zleffke/kicad_active_balun/qucs/lwa_ref/README.md

# LWA Filter Simulations

- lwa_lpf.sch: design built into LWA FEE v1.7, Fc = 158 MHz
- lwa_bpf.sch: proposed LWA BPF:, AM Band rejection.
- lwa_bpf2.sch: proposed LWA BPF, with FM band Notch.
