zleffke/kicad_active_balun/docs/Initial Design/sections/general_information.tex

\newpage
\section{General Information}
\label{sec:general_introduction}

\subsection{Purpose}
\label{subsec:purpose}
The purpose of this document is to describe the initial design of an active HF dipole antenna. This document is intended to provide the initial design decisions that went into the development of this antenna system.  While the full antenna wil eventually be discussed, this document will primarily discuss the development and test of the core Printed Circuit Board (PCB) developed for the project. 

\subsection{Scope}
\label{subsec:scope}
As an initial design document, the scope of this document may be fairly broad.  The primary focus will be on the development of the core PCB active dipole balun board.  The document may also include test procedures, test results,  antenna performance on air, and other areas as necessary.

\subsection{Project References}
\label{subsec:references}
LWA Memo Series: \url{https://www.faculty.ece.vt.edu/swe/lwa/}

\noindent Reeve Observatory LWA Antenna Page:\\ \url{http://www.reeve.com/RadioScience/Antennas/ActiveCrossed-Dipole/LWA_Antenna.htm}

\noindent HamSCI: \url{https://hamsci.org/basic-project/personal-space-weather-station}

\subsection{Technical Points of Contact}
\label{subsec:poc}
\renewcommand{\arraystretch}{1.2}
%\begin{center}
	\begin{tabular}{|r|l|}
		\hline
		Name: & Zach Leffke \\
		\hline
		Email: & zleffke@vt.edu \\
		\hline
		Phone: & (540)808-6305 \\
		\hline
	\end{tabular}
%\end{center}
