zleffke/kicad_active_balun/docs/Initial Design/sections/prototype.tex

\newpage
\section{Prototype Crossed Dipole HF Antenna}

\label{sec:prototype}

\subsection{Antenna Element Selection}
\label{subsec:proto_ant_element}

\subsection{PCB Assembly}
\label{subsec:proto_pcb}
