zleffke/kicad_active_balun/docs/Initial Design/sections/schematic.tex

\newpage
\section{Schematic}
\label{sec:schematic}

The interested reader is highly encouraged to read the relevant documentation from the LWA Memo Series.

\begin{sidewaysfigure}
  \centering
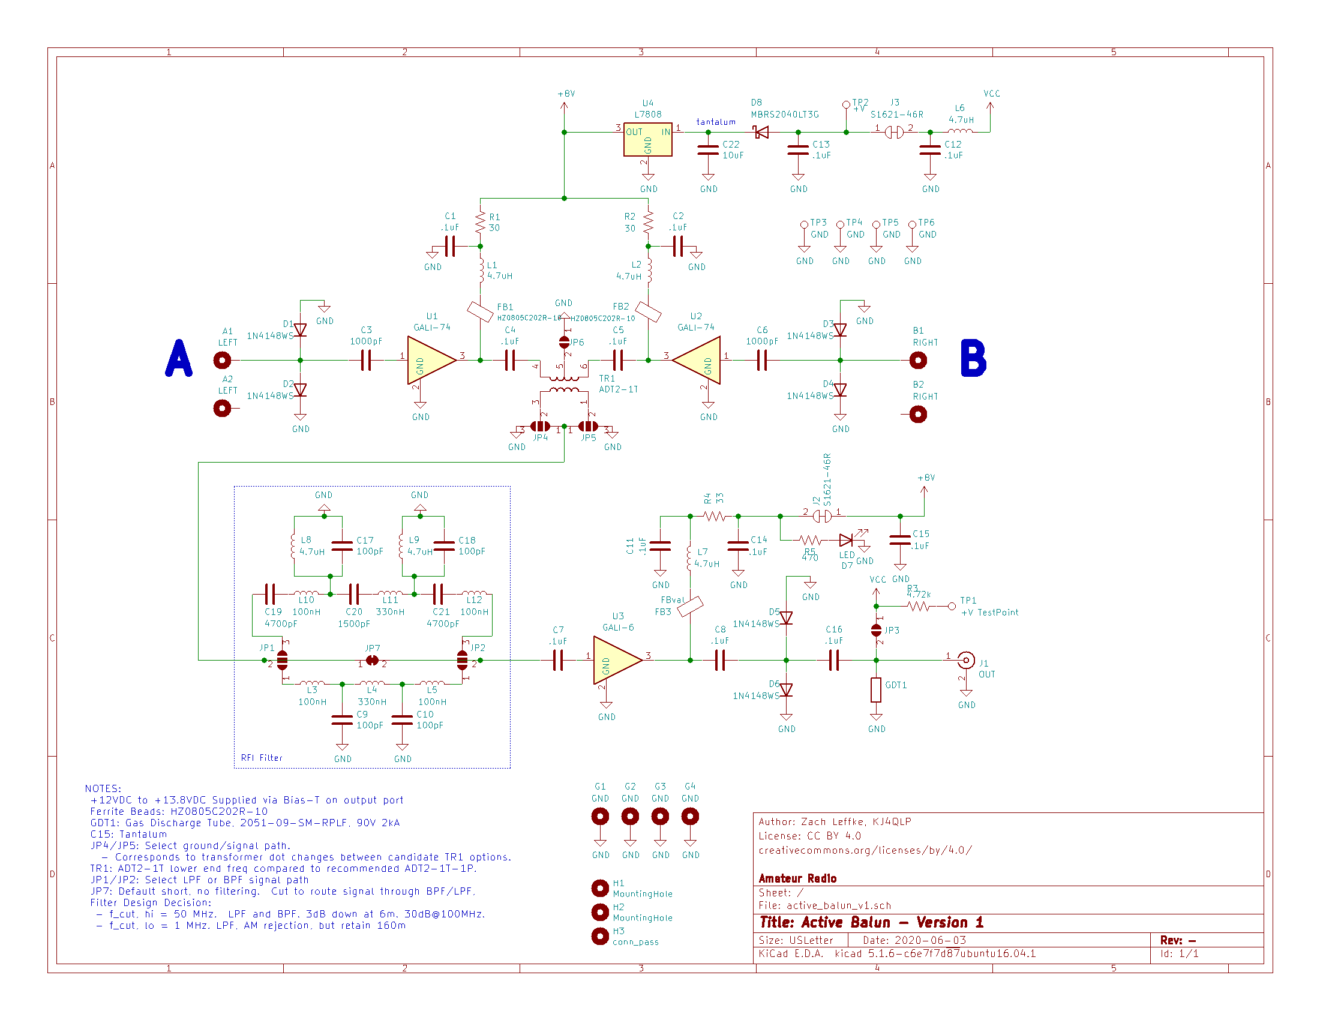
[picture p2: docs/Initial Design/figures/schematic.png]
  
  \caption{Version 1, Revision - Schematic.}
  \label{fig:schematic}
\end{sidewaysfigure}

\begin{figure}[h]
  \centering
  \begin{subfigure}{.45\textwidth}
    \centering
    
    \caption{PCB Top.}
	\label{fig:osh_park:top}
  \end{subfigure}%
  \begin{subfigure}{.45\textwidth}
    \centering
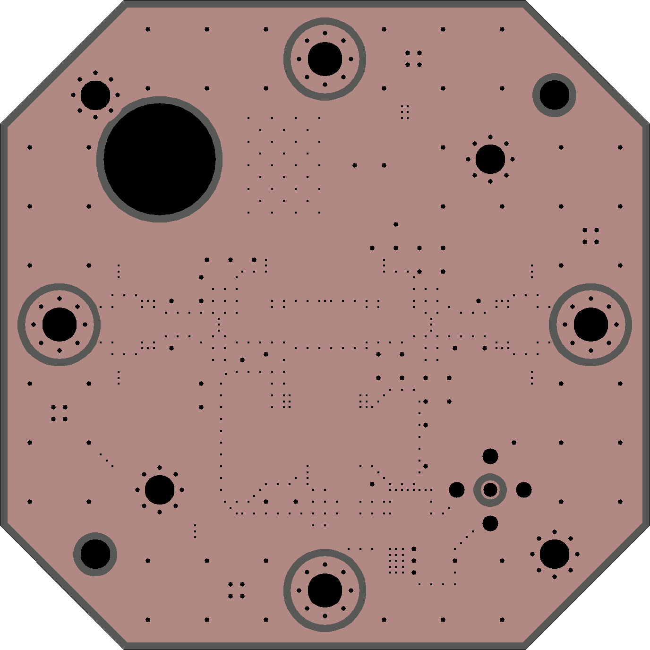
[picture p3: docs/Initial Design/figures/osh_park_bottom_view.png]
    
    \caption{PCB Bottom.}
	\label{fig:osh_park:bottom}
  \end{subfigure}
  \caption{Prefabrication PCB depiction from Osh Park.}
  \label{fig:osh_park}
\end{figure}
