zleffke/kicad_active_balun/docs/Initial Design/initial_design.pdf

# Active HF Dipole Balun Initial Design Document

Project | Active HF Crossed Dipole, HamSCI PSWS
Document ID | AHFDB-IDD
Version | 0.0.1
Date | 20200716
Prepared By | Zach Leffke, KJ4QLP
Keywords | HF Crossed Dipole, SDR, HamSCI PSWS

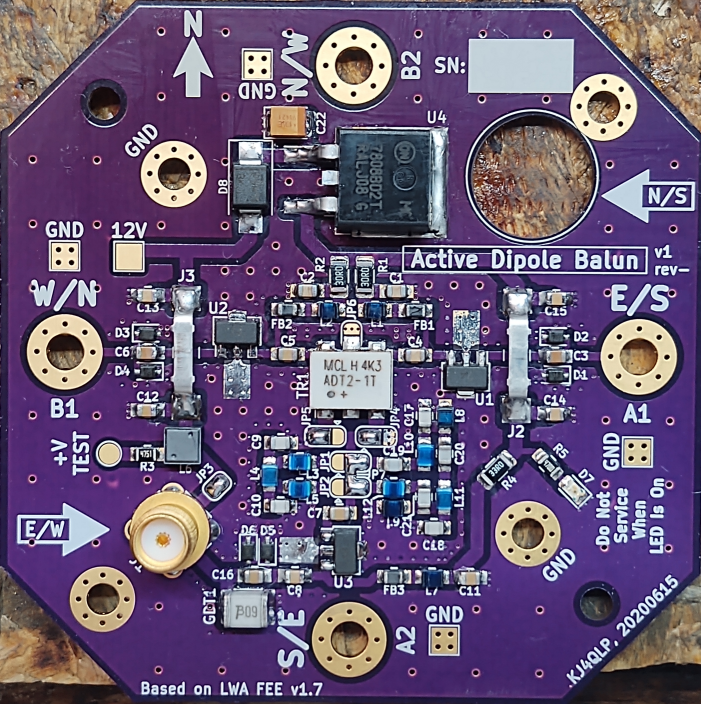
[picture p7: figure]
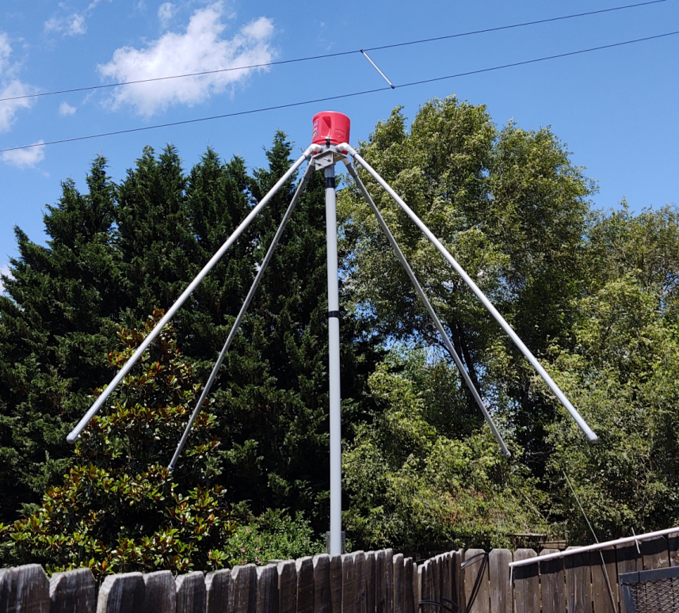
[picture p8: figure]

KJ4QLP

AHFDB-IDD | v0.0.1

## Contents

1 Executive Summary | 2
2 Introduction | 2
2.1 Motivation | | 3
2.2 Design Inspiration - LWA FEE v1.7 | | 3
2.3 Project Goals | | 3
2.3.1 | Open Design | | 3
2.3.2 | Technical | | 4
3 Technical Description | 4
3.1 Background | | 4
3.2 Design Feature Overview | | 5
3.3 Design Deviations from LWA | | 7
3.3.1 | 180◦ Hybrid Combiner vs RF Transformer | | 7
3.3.2 | Filtering | | 8
3.3.3 | Voltage Regulator | | 10
3.4 Polarization | | 10
4 Schematic | 12
5 Measurement | 14
5.1 Performance Metrics Definition | | 14
5.2 Measurement Results | | 14
6 Prototype Crossed Dipole HF Antenna | 15
6.1 Antenna Element Selection | | 15
6.2 PCB Assembly | | 15
7 Conclusion | 16

## List of Figures

1 | Block Diagram of Single Polarization Active HF Dipole Balun | | 2
2 | LWA-FEEv1.7 low pass filter schematic and response simulation in QUCS | | 8
3 | Active HF dipole balun version 1, revision- (AHFDB, v1, rev-) low pass filter schematic
and response simulation in QUCS | | 9
4 | Noise Figure Measurement Setup | | 11
5 | Version 1, Revision - Schematic | | 13
6 | Prefabrication PCB depiction from Osh Park | | 14
20200716 | KJ4QLP | i

AHFDB-IDD | 0.0.1

## List of Tables

1 | Relevant documents from the LWA Memo Series | | 5
2 | Summary of Active HF Dipole Balun Performance Parameters | | 6
3 | Summary of design deviations from the LWA-FEEv1.7 reference design | | 7
4 | Pinouts of the Mini-Circuits ADT2-2-1T-1P & the ADT2-1T RF transformers . . . | 8
20200716 | KJ4QLP | 1/ 16

## 1 Executive Summary

This paper presents the initial design information describing an Active HF Dipole Balun (AHFDB). A single balun board provides a single linear polarized dipole antenna for HF receive only applications. A pair of balun boards can be combined to produce an active HF crossed dipole, which when phased together properly can produce circular polarization for Extraordinary and Ordinary mode discrimination. The fundamental design is heavily based on the LWA Front End Electronics, version 1.7 (LWA-FEEv1.7) from the Long Wavelength Array radio astronomy instrument, with notable differences and adaptations to make it easy to reproduce and to reduce overall costs. To date, three balun boards have been assembled and heavily tested. This includes extensive benchtop measurements of RF parameters such as Gain, Noise Figure, Input P1dB, IIP3, Input VSWR, Output VSWR, and response of the integrated RFI filters. This testing also included on air measurements with an assembled active HF crossed dipole which utilizes two of the assembled baluns. The on air testing includes comparisons measurements to two commercial antennas, an active magnetic loop from DX Engineering and a Tilted Terminated Dipole Antenna (T2FD). This project was undertaken by the author in order to provide a low cost alternative to more expensive commercially available products of similar design. The goal of this document is to provide the design details of this device in an readily accessible way so that other experimenters can easily reproduce the design. While intended for Amateur Radio experimenters and DIYers, the overall design is intended to be sufficient for the conduct of serious radio science research. Overall, the design performs very well, generally as good or better than commercial variants, at a dramatically reduced cost. Figure 1 below shows the high level block diagram of a single balun design.

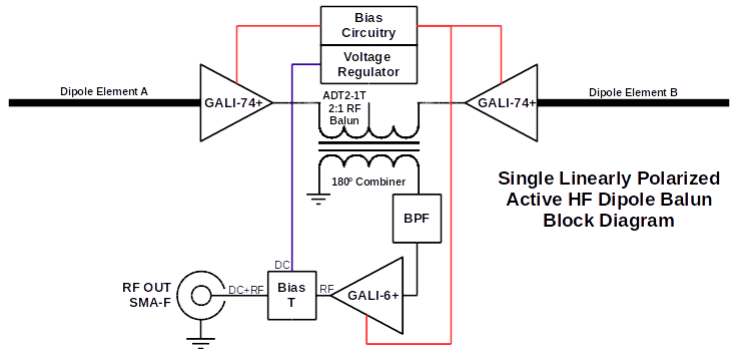
[picture p9: figure]

Figure 1: Block Diagram of Single Polarization Active HF Dipole Balun.

## 2 Introduction

This paper will provide a description of the Active HF Dipole Balun design. Like the base design, the author hopes to take inspiration from the Long Wavelength Array (LWA) radio astronomy project in the form of a Memo Series documenting the development of this project. This document

20200716 | KJ4QLP | 2/ 16

is a starting point to capture the main ideas and high level information. As the design progresses, this document may be condensed and content moved into other more focused documents.

### 2.1 Motivation

For a while now, the author has been interested in developing an active HF Dipole antenna system for HF reception. This is in part due to an interest in the Amateur Radio hobby and general interest in ionospheric science and associated instrumentation. The HamSCI Personal Space Weather Station (PSWS) project has also served as motivation to pursue this effort. This project is also related to an interest of the author in developing HF reception and transmission systems as part of his professional work with the Virginia Tech Hume Center for National Security and Technology. This includes HF systems for both ground based observations as well as space based reception/transmission of HF signals (ePOP RRI). The author would like to thank the VT Hume Center for use of the RF test equipment used to perform detailed RF measurements of the design presented in this work.

### 2.2 Design Inspiration - LWA FEE v1.7

Through research into active HF antenna systems and digital receiver systems, the author has come across the LWA Memo Series hosted by Dr. Steve Ellingson of Virginia Tech (VT) [1]. This information was initially discovered when looking through the excellent content on the Reeve Observatory website [2]. The Long Wavelength Array is a radio astronomy instrument that consists of hundreds of active HF crossed dipole antenna elements and involves UNM, VT, LANL, JPL, NRL, Caltech, Harvard, NRAO, and AFRL. At least two such large arrays exist, one in Socorro, NM at the Very Large Array (VLA) site [3] and one at the Owens Valley Radio Observatory (OVRO) site in California [4].
The LWA Memo series contains over two hundred individual documents concerning the design of the entire radio astronomy instrument. This memo series includes everything from the base antenna design (of interest to this work), to the siting requirements for the observatories, to the correlator designs, to the networking requirements, and many other topics. Reading through the excellent information on both the Reeve Observatory site and the LWA Memo Series has lead the author to consider the use of the LWA design for the an active HF antenna design for Amateur Radio use and Ionospheric science research.
The fundamental design of the active balun PCB board presented in this work is based directly on the LWA Front End Electronics (FEE) v1.7 board, with notable differences that will be discussed later. The author in no way claims credit for the base design as it is directly taken from the LWA documents. The author would like to thank the LWA researchers and engineers for publishing such excellent, detailed, and readily accessible information concerning the design of their antenna system.

### 2.3 Project Goals

### 2.3.1 Open Design

A primary goal of this project is to provide a low cost solution for experimenters interested in constructing active HF antennas. The intent of the author is to make the design easily accessible,

20200716 | KJ4QLP | 3/ 16

reproducible, and generally easy for others to use and create they’re own. A PCB layout, based on the LWA FEE v1.7 but updated and modified, was done by the author using KiCAD. The PCB layout is open hardware, based on the creative commons license, and available on GitHub for others use, modification, etc. Prototype PCBs were fabricated by Osh Park, and the author is considering making Osh Park project public once a satisfactory design revision has been completed. When made public on the Osh Park page, others can order boards directly by other experimenters rather than having to download the KiCAD designs and creating their own PCB project. The Bill of Materials will also be provided and all components are easily obtainable from local hardware stores and online vendors such as Mouser, Digikey, Osh Park, etc.

### 2.3.2 Technical

There are a number of technical goals for this project that will be discussed in more detail in subsequent sections. This section of the document is intended to provide high level insight into the overall project. The list below shows the basic design goals.

1. Single, linearly polarized, active balun board for an electrically small HF dipole antenna.
2. Modular design to produce a crossed dipole configuration with a pair of active balun boards.
3. Threshold frequency of operation: 3.0 to 30.0 MHz.
4. Objective frequency of operation: 1.5 to 50.0 MHz.
5. High linearity in order to handle strong in band signals.
6. Integrated filtering to provide rejection of the AM broadcast band and the FM broadcast band so as not to overdrive the analog RF front end or the backend SDR.
7. Stable performance across the operating band in potential extreme temperature environments (both hot and cold).
8. Relatively compact design using readily available components. The PCB layout uses surface mount components, nominally 0805 in size, allowing board population by hand. Some components are slightly smaller than this and care must be taken during board population.
9. Overvoltage (due to potential nearby lightning strikes) and surge protection.
10. Integrated Bias-T for DC on the coax power supply or via a separate external source.
11. Readily available component selection from common vendors such as local hardware stores (i.e. Lowe’s) and online vendors such as Digikey, Mouser, Mini-Circuits, and Osh Park.
12. First versions and revisions of the design will include prototyping features in the schematic and PCB layout to allow for experimentation that are not part of the LWA design.

## 3 Technical Description

### 3.1 Background

As mentioned, this design is heavily based on the Long Wavelength Array antenna element design. The reader is highly encouraged to review the relevant documents from the LWA Memo Series as full description of their design is outside the scope of this document [1]. Table 1 below gives a list of the key documents from the LWA Memo Series used in this work. However, when necessary, details of the LWA design will be discussed, particularly when discussing deviations from the LWA

20200716 | KJ4QLP | 4/ 16

design as summarized in Table 3. The documents listed in the table pertain specifically to the technical design of the active balun board. There are a number of other documents on the LWA Memo Series [1] that discuss topics such as the antenna element design (blade, wire, etc.), antenna patterns, ground screens, RFI site surveys, potential applications of the LWA, along with many other topics for the overall radio observatory that are not relevant to this work (though all make for very interesting reads).

Table 1: Relevant documents from the LWA Memo Series.

Memo# | Document Title
190 | Collected LWA Engineering Memos from the Development of the Front End Elec-tronics (FEE) [5]
188 | Preliminary Design of the LWA-1 Array, Antenna, Stand, Front End Electronics, and Ground Screen [6]
87 | A Comparison of Two Power Combining Elements for LWA Active-Baluns - 180◦ Hybrid versus Wideband Transformer [7]
120 | The Rapid Test Array Balun (G250R) [8]
135 | Bias-T Design Considerations for the LWA [9]

### 3.2 Design Feature Overview

A single balun board provides the necessary electronics for a single linearly polarized HF dipole antenna. The active balun board provides good performance across the objective frequency of operation from approximately 1.5 to 50.0 MHz, with good rejection in the AM and FM broadcast bands. The performance values given in this section are the average values for the nominal frequency of operation, with more detailed measured performance given in later sections. The active balun board provides an average gain of 36.1 dB. The input third order intercept point (IIP3) is approximately -2.5 to -3.0 dBm across the operating band. The input 1dB Compression Point (P1dB) is approximately -18.41 dBm across the operating band. Note that linearity measurements (IIP3 and P1dB) are taken with the output ESD protection diodes removed from the boards under test, per the measurement techniques described in the LWA documents.
The active HF dipole balun board utilizes a pair of GALI-74+ amplifiers from Mini-Circuits as the primary active amplifier device, one for each element of a single dipole. The signals from each dipole element are then combined using the secondary coil of a Mini-Circuits ADT2-1T RF transformer, which also provides a 180 degree phase shift between the two elements. The ADT2-1T transformer also provides a 2:1 impedance ratio, converting a nominal 100Ω secondary coil to a 50Ω output impedance on the primary coil. The signal is then routed through either a low pass or a band pass RFI filter via surface mount solder jumpers. In its default configuration, these filters are bypassed with a surface mount trace that can be cut with a razor blade if the the filters are desired to be used. The output of the filters are then passed to a GALI-6 amplifier.
A number of surge protection devices and decisions are included in the LWA-FEEv1.7 design
20200716 | KJ4QLP | 5/ 16

and remain essentially unaltered in this design. This includes 1N914 double backed diodes on the RF input and RF output lines serving as ESD protection. The design also includes a Gas Discharge tube on the RF output path to protect back end electronics from damaging lightning surges. These diodes directly effect the measurement process, particularly with respect to linearity measurements (IIP3 and P1dB), as mentioned previously. Finally, the two input capacitors, connected to the dipole element arms, are rated for 1000 volts. This decision is elaborated on in the failure analyses presented in the LWA documentation [5] where the original capacitors had failed short. This was presumably due to nearby lighting that produced an overvoltage condition.
The PCB hole patterns are designed so that a second balun board can be flipped 180 degrees along the top left to bottom right diagonal and maintain proper alignment. When this is done, the two boards can be mechanically mated and held together with four 4-40 screws. The solder mask on the bottom of the PCBs has been removed such that the ground planes of the two boards are also electrically connected. The second PCB SMA connector can then be mounted on the bottom of the PCB and aligned with the large hole in the upper right section of the top PCB, resulting in both SMA connectors pointing ‘up.‘
Each balun board consumes approximately 250 mA when supplied with approximately 13.8VDC. Power is nominally supplied via the output RF coaxial cable, and the design contains an integrated bias-t circuit. In addition, the board allows for direct supply of power via solder pads that bypass the input bias-t. The bias-t can be completely disconnected from the output RF by disconnecting a solder jumper, though the expected power arrangement when fielded should be via the coaxial cable, which provides a degree of shielding, rather than via a separate power line (which also increases overall costs).

Table 2: Summary of Active HF Dipole Balun Performance Parameters.

Parameter | Symbol | Unit | Value
Frequency of Operation | fnom | MHz | 1.5 to 50
Integrated BPF, low -3dB cutoff | flo | MHz | 1.0
Integrated BPF, high -3dB cutoff | fhi | MHz | 50.0
Integrated BPF, high -3dB cutoff | fhi | MHz | 50.0
Average Gain | Gavg | dB | 36.1
Input Compression Point | P1dB | dBm | -18.41
Input Third Order Intercept Point | IIP3 | dBm | -2.5 to -3.0
DC Input Voltage, Range | Vin,range | V | 10.0 to 35.0
DC Input Voltage, Nominal | Vin,nom | V | 13.8
DC Supply Current, Nominal | Isupply | mA | 250.0
DC Supply Method, Nominal | N/A | N/A | bias-t via coax
DC Supply Method, Alternate | N/A | N/A | external
20200716 | KJ4QLP | 6/ 16

### 3.3 Design Deviations from LWA

Table 3: Summary of design deviations from the LWA-FEEv1.7 reference design.

LWA Design | AHFDB Design
Frequency: 10 to 88 MHz | Frequency: 1.5 to 50 MHz
Teletech 180◦ hybrid combiner | Mini-Circuits RF transformer
Low Pass Filter | LPF, BPF, Filter Bypass
12V Voltage Regulator | 8V Voltage Regulator
LWA-FEEv1.7 PCB form factor | More compact PCB form factor

3.3.1 180◦ Hybrid Combiner vs RF Transformer

The LWA-FEEv1.7 utilizes a Tele-Tech HX62A 180◦ hybrid combiner to combine the signals from each side of a single polarization dipole element. The LWA documentation quotes various costs for this single component range from $20.00 per unit when >500 are purchased [6] to $31.50 per unit >500 units are purchased [5]. The lower cost is from a more recent document (2009), and for a dual polarization implementation two of these units would be required. The cost for 2 units is likely higher than the quoted costs which assumes a purchase quantity of more than 500 units. This is cost prohibitive for this project, therefore it was decided that the Tele-Tech HX62A is a non-starter for this project and a suitable, lower cost alternative is required, even if that means accepting a compromise in performance.
The LWA engineers performed an analysis comparing the Tele-Tech HX62A to a Mini-Circuits ADT2-2-1T-1P RF transformer [7]. The results of the analysis show that the HX62A outperforms the ADT2-2-1T-1P. The conclusion of that document is that the increased cost of the Tele-Tech device is worth the increased performance for the LWA design goals. The Mini-Circuits component is drastically lower in cost, and the author believed it was a suitable for this project. However, according to the Mini-Circuits ADT2-2-1T-1P datasheet, the low end frequency response bottoms out around 8 MHz, and the new design is striving for low end performance down to approximately 1.5 MHz to cover the 160m Amateur Radio Band. Alternatively, the Mini-Circuits ADT2-1T datasheet shows a low end response of 0.4 MHz, as well as decreased insertion loss and better return loss across the HF band. The cost of this device is $5.77 per unit on Minicircuits. For this reason, the ADT2-1T was selected for this project.
Table 4 shows the pinouts for the RF transformers. Careful scrutiny of pins 4 and 6 shows that there is an inversion of the secondary between the two transformers, which has implications for the phase of the output signal on the primary coil. In the LWA comparison document [7], pin 3 (primary dot signal) is grounded. Due to the inversion of the primary/secondary orientation on the ADT2-1T compared to the ADT2-2-1-T, the author elected to include solder jumpers in the PCB layout that allows alternate signal routing paths. This allows for experimentation with which pin is grounded and the resulting phase. For the default test case in the version 1, rev- design, pin 1 (primary signal) is grounded to account for the phase inversion. Likely, this concern probably
20200716 | KJ4QLP | 7/ 16

Table 4: Pinouts of the Mini-Circuits ADT2-2-1T-1P & the ADT2-1T RF transformers

Pin | ADT2-2-1T-1P | ADT2-1T
1 | primary | primary
2 | not used | not used
3 | primary dot | primary dot
4 | secondary dot | secondary
5 | secondary ct | secondary ct
6 | secondary | secondary dot

doesn’t matter as long as the active balun boards are consistent, therefore the solder jumpers will likely be removed in future revisions.

### 3.3.2 Filtering

The original LWA design utilizes a 5 pole Butterworth Low Pass Filter (LPF) as a modest Radio Frequency Interference (RFI) filter with a -3dB cutoff frequency of approximately 150 MHz. Figure 2 below shows a Quiet Universal Circuit Simulator (QUCS) simulation of the LWA LPF included in the LWA-FEEv1.7 according to the LWA design documents [5]. With a 3dB bandwidth that spans DC to 150 MHz, effectively no rejection of either the broadcast AM or broadcast FM bands are provided.


Figure 2: LWA-FEEv1.7 low pass filter schematic and response simulation in QUCS.

20200716 | KJ4QLP | 8/ 16

As described earlier, a design goal of this project is to aim for a nominal operating bandwidth between 1.5 MHz and 50.0 MHz. Another goal is to provide some amount of rejection to the broadcast AM and broadcast FM bands. While some of the LWA documents do discuss the inclusion of a notch filter for the broadcast FM band around 98 MHz (center of the FM band), due to the overall changes in the desired operating frequency, the author elected to replace the LPF with a bandpass filter (BPF). For experimentation purposes, the author elected to also include a low pass filter with a modified -3dB cutoff frequency of 50 MHz. Again, selection of the desired filter (LPF or BPF) is accomplished via solder jumper signal routing. In addition to the LPF and BPF, the actual default configuration of the filter section of the PCB is to bypass all filters, again with a surface mount PCB jumper. During initial PCB assembly, this jumper can be cut with a small razor blade and the solder jumpers are then used to route the signal through either the BPF or the LPF. The author utilized QUCS to design the initial filters, which are 5 both pole Butterworth designs. The computed ideal values for the capacitors and inductors were then modified to match readily available standard values. The circuit design and results of the QUCS simulation for the new LPF is shown in Figure 3a and for the new BPF in Figure 3b.


(a) AHFDB v1,rev- low pass filter. | (b) AHFDB v1,rev- band pass filter.

Figure 3: Active HF dipole balun version 1, revision- (AHFDB, v1, rev-) low pass filter schematic and response simulation in QUCS.

Notice the upper -3dB cutoff frequency for both filters in Figure 3 is approximately 50 MHz. At approximately 98 MHz, the center of the broadcast FM band, both filters achieve approximately -30 dB of rejection. The lower -3dB cutoff frequency of the BPF is approximately 1.0 MHz, with minimal insertion loss around 1.8 MHz (the low end of the Amateur Radio 160m band). This low end is a bit below the upper edge of the AM broadcast band (1.6 MHz), but because of the close proximity to the Amateur Radio 160m band, a balance had to be struck. For this first test, it was decided to go with the 1 MHz cutoff as the actual filter performance is not expected to perfectly match the QUCS simulations and the design could be optimized later. On air performance tests at

20200716 | KJ4QLP | 9/ 16

the author’s QTH, presented in more detail later, shows this provides sufficient AM band rejection of local nearby AM stations (including one station less than 1 mile from the author’s QTH). Adding additional poles to the filters is possible, but will increase insertion loss in the pass band. Adding a notch filter is also feasible. As this is an Open Hardware design, including the QUCS simulations, KiCAD schematic, and PCB layout, others are encouraged to experiment with these values to find the right filter response for their local RFI environment.

### 3.3.3 Voltage Regulator

The LWA-FEEv1.7 utilizes a 12V voltage regulator onboard the PCB. For this design, the author has considered the possibility that the antenna may be utilized during portable operations operating from batteries. Prior experience has shown that nominal 12V batteries when fully charged can reach voltages in excess of 14 volts. When depleted 12V batteries can drop as low as 10 to 11 Volts. Therefore, the author made a design decision to down size the onboard voltage regulator to an 8 volt output voltage regulator in order to allow operation at supply voltages as low as approximately 10 volts. This decision has a couple of implications.
First, the bias resistors for the GALI-74 and GALI-6 amplifiers must be modified to account for this change in the overall supply voltage. This is easily accomplished and the Mini-Circuits datasheets provide recommended bias resistor values for various circuit supply voltages. The author did actually experiment with lower than recommended bias resistor values in order to increase the current draw of the balun boards. This was done based on the higher compression point and third order intercept point values shown in the detailed test data documents provided by Mini-Circuits. Ultimately though, this was abandoned and the author reverted to a single bias resistor value of 39 ohms for all three RF amplifiers in the design. Further linearity testing may be conducted on future revisions of the design.
Second, a single polarization board pull approximately 250 mA (at 13.8V input voltage). When using a standard 13.8V power supply (common in Amateur Radio), this results in a voltage difference of approximately 5.8V between the input and output voltages of the regulator. A simple rule of thumb for computing the waste power through a linear regulator is to multiply the current draw by the voltage difference. This results in approximately 1.45 Watts of waste power for a single board and approximately 2.90 Watts when configured for dual polarization. This waste power is not insignificant and manifests in the form of heat. The voltage regulator is a D2PAK form factor and the heat is conducted into the ground plane of the PCB. The ground planes of a dual polarization stack are in contact with each other when mechanically mated. The result of all this is that the temperature of the balun boards achieved a fairly high temperature that was hot to the touch. However, no part of the board was hot enough to cause burns or pain and the increased temperature may actually help stabilize the overall balun temperature when fielded in a completed system, particularly in colder regions.

### 3.4 Polarization

A single active balun PCB board provides a single linearly polarized, electrically small dipole, also referred to as a short dipole. The PCB is designed in such a way that a pair of active balun boards can be stacked together to produce a crossed dipole. The crossed dipole design is desirable

20200716 | KJ4QLP | 10/ 16

in order to discriminate between Ordinary and Extraordinary mode waves. Like the LWA, the author intends to explore the use of digital receiver techniques for digitizing each linear element. The combining of the signals to produce any polarization, from linear, to elliptical, to circular can then be done in software (i.e. GNU Radio) to explore measurement techniques of the propagating wave Stokes parameters. Alternatively, experimenters may employ a 90 degree hybrid to directly produce Right Hand Circular Polarization (RHCP) and Left Hand Circular Polarization (LHCP) in the analog domain (refer to the Reeve observatory site for more information on this topic [2]). Ordinary and Extraordinary discrimination (RHCP/LHCP)

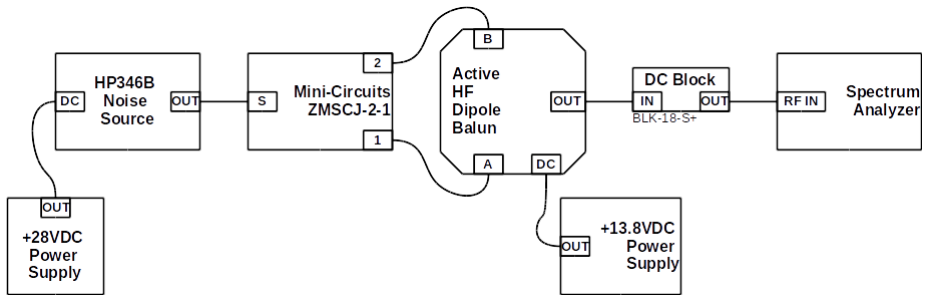
[picture p10: figure]

Figure 4: Noise Figure Measurement Setup.

20200716 | KJ4QLP | 11/ 16

## 4 Schematic

The interested reader is highly encouraged to read the relevant documentation from the LWA Memo Series.

20200716 | KJ4QLP | 12/ 16

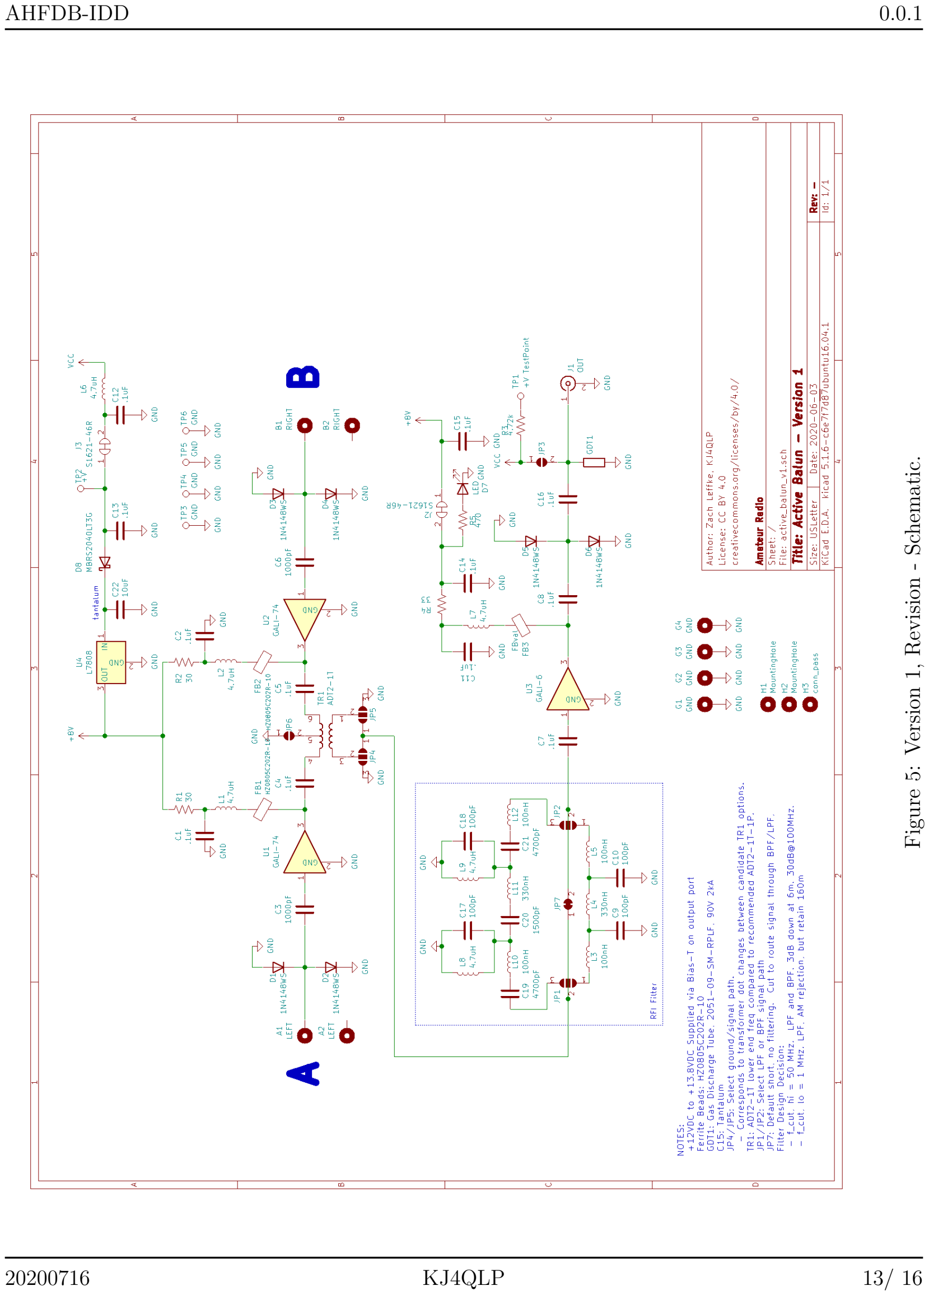
[picture p11: page 15]

AHFDB-IDD | 0.0.1Figure 5: Version ¹, Revision ⁻ Schematic.
20200716 | KJ4QLP | 13/ 16

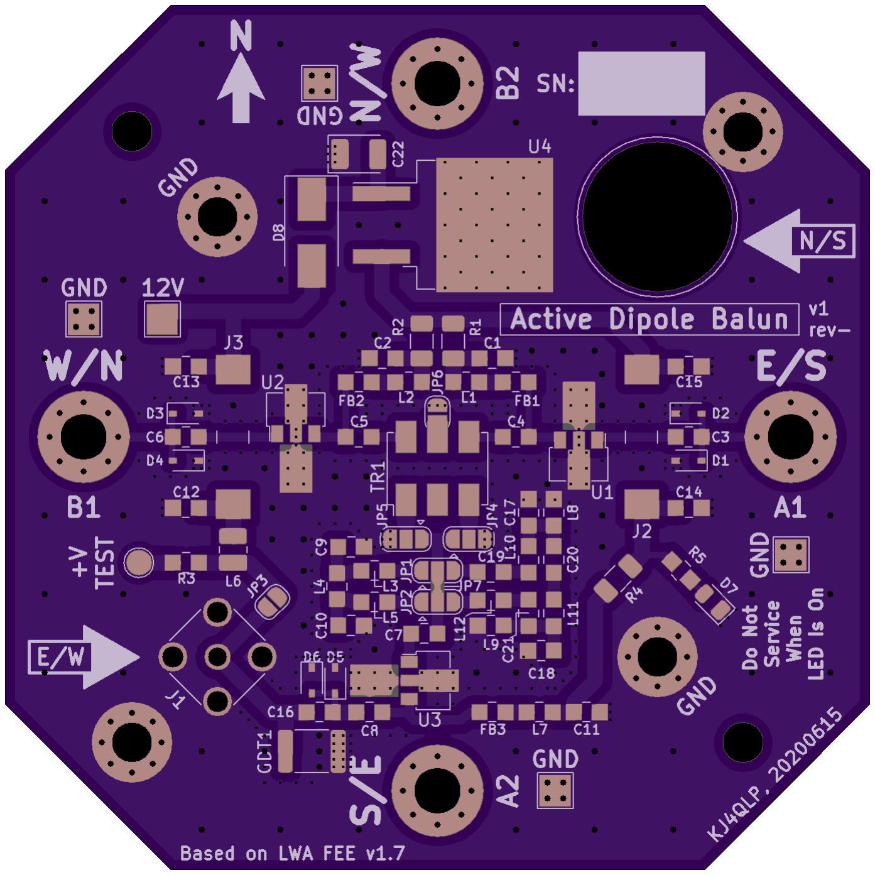
[picture p12: figure]
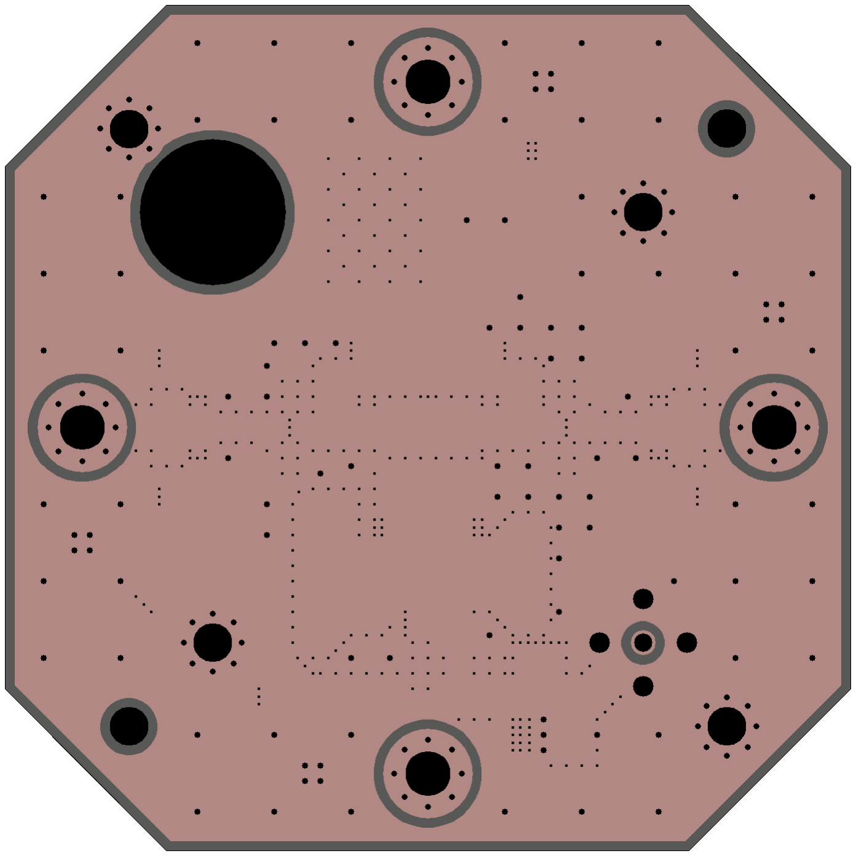
[picture p13: figure]

(a) PCB Top. | (b) PCB Bottom.

Figure 6: Prefabrication PCB depiction from Osh Park.

## 5 Measurement

### 5.1 Performance Metrics Definition

### 5.2 Measurement Results

Version 1, Revision - (pronounced ‘rev dash’) Serial Number Tested: 003

20200716 | KJ4QLP | 14/ 16

## 6 Prototype Crossed Dipole HF Antenna

### 6.1 Antenna Element Selection

### 6.2 PCB Assembly

20200716 | KJ4QLP | 15/ 16

## 7 Conclusion

## References

[1] “LWA Memo Series,” Accessed Jul. 18, 2020. [Online]. Available: https://www.faculty.ece.vt.edu/swe/lwa/ (https://www.faculty.ece.vt.edu/swe/lwa/)
[2] “Long Wavelength Array Active Crossed-Dipole Antenna,” Accessed Jul. 18, 2020. [Online]. Available: http://www.reeve.com/RadioScience/Antennas/ActiveCrossed-Dipole/ LWA Antenna.htm (http://www.reeve.com/RadioScience/Antennas/ActiveCrossed-Dipole/LWA_Antenna.htm)
[3] “Long Wavelength Array, Catching big waves with small blades,” Accessed Jul. 18, 2020. [Online]. Available: http://www.phys.unm.edu/∼lwa/index.html (http://www.phys.unm.edu/~lwa/index.html)
[4] “The Owens Valley Long Wavelength Array,” Accessed Jul. 18, 2020. [Online]. Available: http://www.tauceti.caltech.edu/LWA/index.html
[5] “Collected LWA Engineering Memos from the Development of the Front End Electronics (FEE),” Accessed Jul. 18, 2020. [Online]. Available: https://www.faculty.ece.vt.edu/swe/lwa/memo/lwa0190.pdf (https://www.faculty.ece.vt.edu/swe/lwa/memo/lwa0190.pdf)
[6] Brian Hicks, Steve Burns, Tracy Clarke, Jacob Hartman, Norm McGlothlin, Nagini Paravastu, Paul S. Ray, Henrique Schmitt, and Ken Stewart, “Preliminary Design of the LWA-1 Array, Antenna, Stand, Front End Electronics, and Ground Screen,” in LWA Memo Series, 2009, no. 188, Accessed Jul. 18, 2020. [Online]. Available: https://www.faculty.ece.vt.edu/swe/lwa/memo/lwa0188.pdf
[7] Brian Hicks, Nagini Paravastu, Paul Ray, Bill Erickson, “A Comparison of Two Power Combining Elements for LWA Active-Baluns - 180◦ Hybrid versus Wideband Transformer,” in LWA Memo Series, 2007, no. 87, Accessed Jul. 18, 2020. [Online]. Available: https://www.faculty.ece.vt.edu/swe/lwa/memo/lwa0087.pdf
[8] Brian Hicks (NRL), Nagini Paravastu (ASEE/NRL), “The Rapid Test Array Balun (G250R),” in LWA Memo Series, 2007, no. 120, Accessed Jul. 18, 2020. [Online]. Available: https://www.faculty.ece.vt.edu/swe/lwa/memo/lwa0120.pdf
[9] Brian Hicks and Bill Erickson, “Bias-T Design Considerations for the LWA,” in
LWA Memo Series, | 2008, | no. 135, | Accessed Jul. 18, | 2020. [Online]. Available:
https://www.faculty.ece.vt.edu/swe/lwa/memo/lwa0135.pdf
20200716 | KJ4QLP | 16/ 16
