zleffke/kicad_active_balun/docs/hamsci_20200723/images/AHFDB_BPF_Response.png

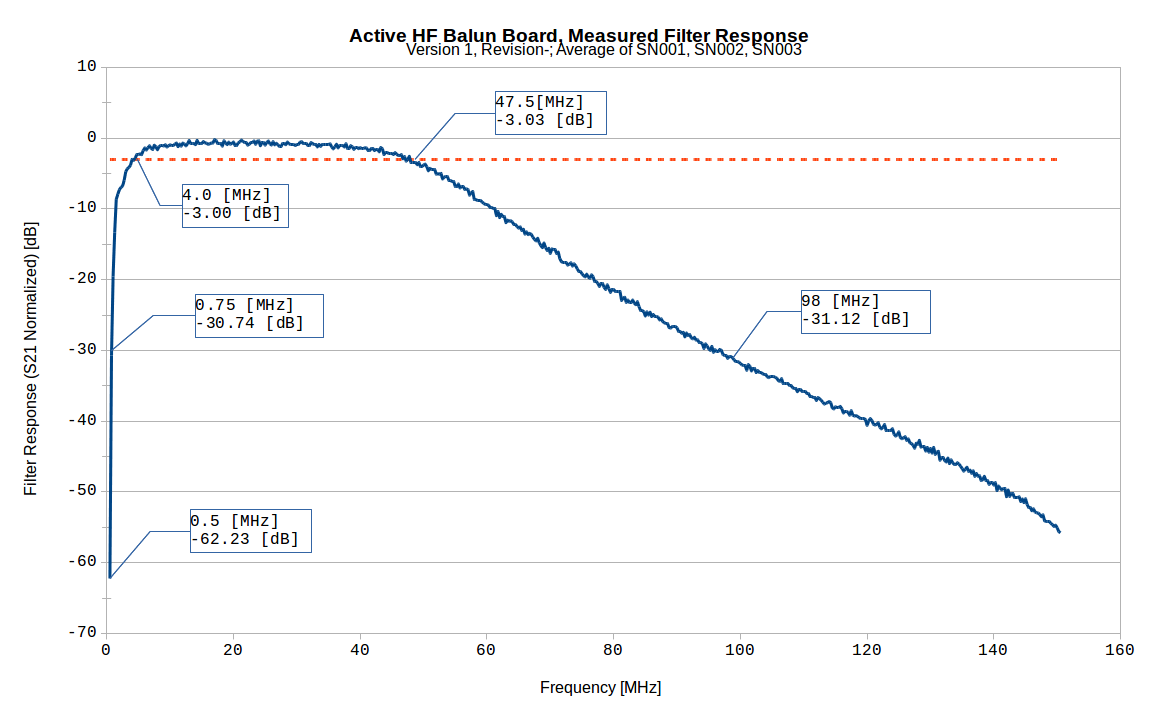
docs/hamsci_20200723/images/AHFDB_BPF_Response.png
