zleffke/kicad_active_balun/docs/hamsci_20200723/images/AHFDB_GainS21.png

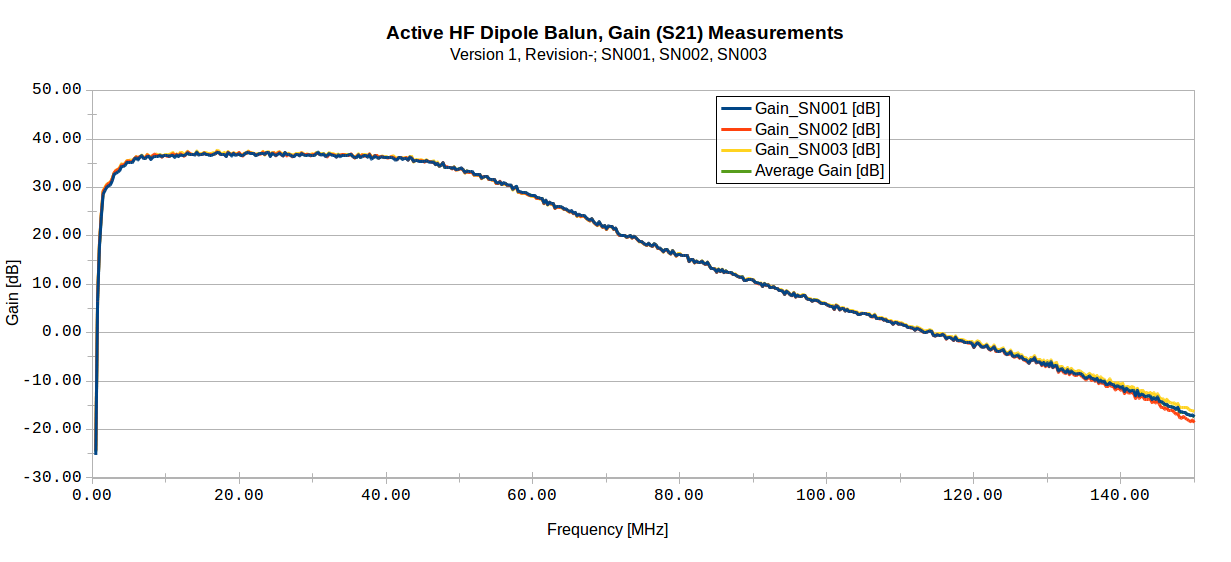
docs/hamsci_20200723/images/AHFDB_GainS21.png
