zleffke/kicad_active_balun/docs/hamsci_20200723/images/AHFDB_IIP3.png

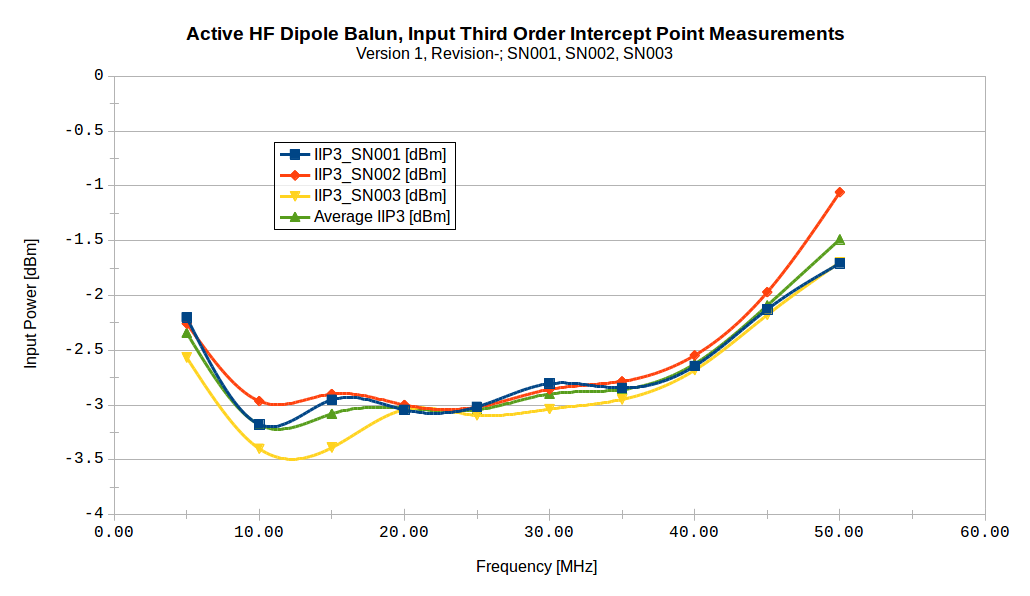
docs/hamsci_20200723/images/AHFDB_IIP3.png
