zleffke/kicad_active_balun/docs/hamsci_20200723/images/AHFDB_NoiseFigure.png

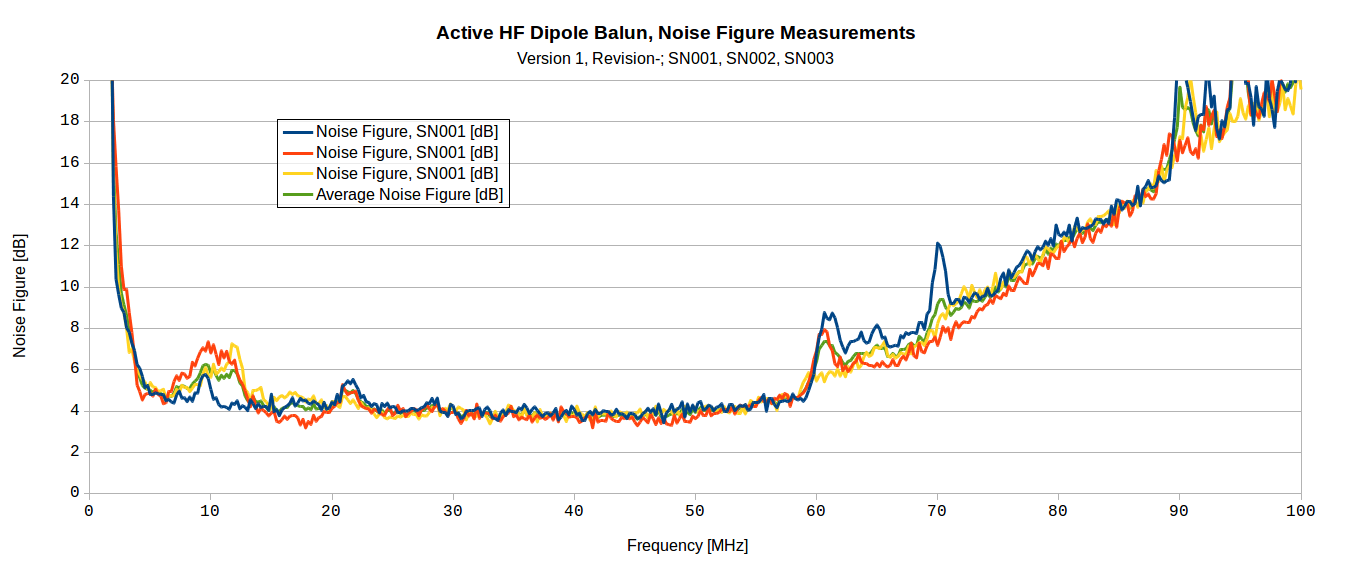
docs/hamsci_20200723/images/AHFDB_NoiseFigure.png
