zleffke/kicad_active_balun/docs/hamsci_20200723/images/bad_inductor.jpg

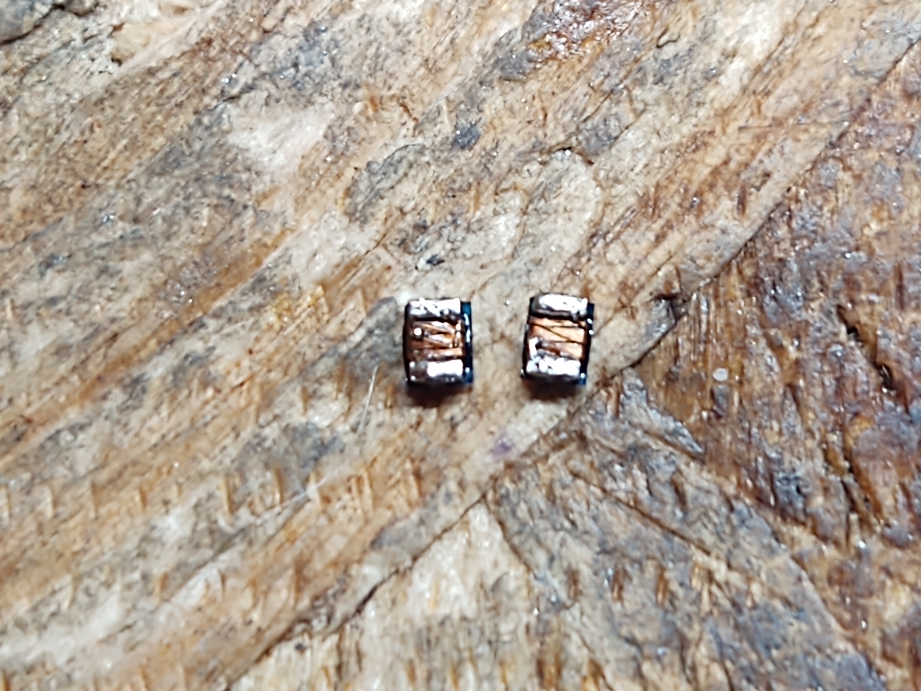
docs/hamsci_20200723/images/bad_inductor.jpg
