zleffke/kicad_active_balun/docs/hamsci_20200723/images/Gain_stderr.png

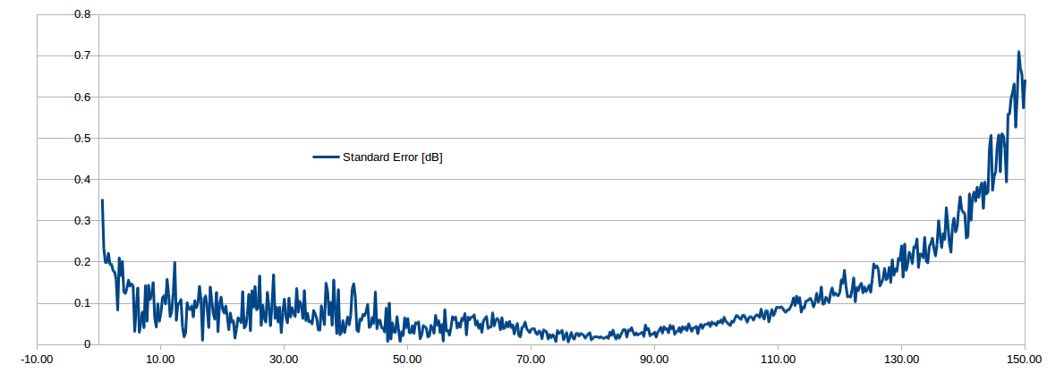
docs/hamsci_20200723/images/Gain_stderr.png
