zleffke/kicad_active_balun/docs/hamsci_20200723/images/IMG_20200620_014855542.jpg

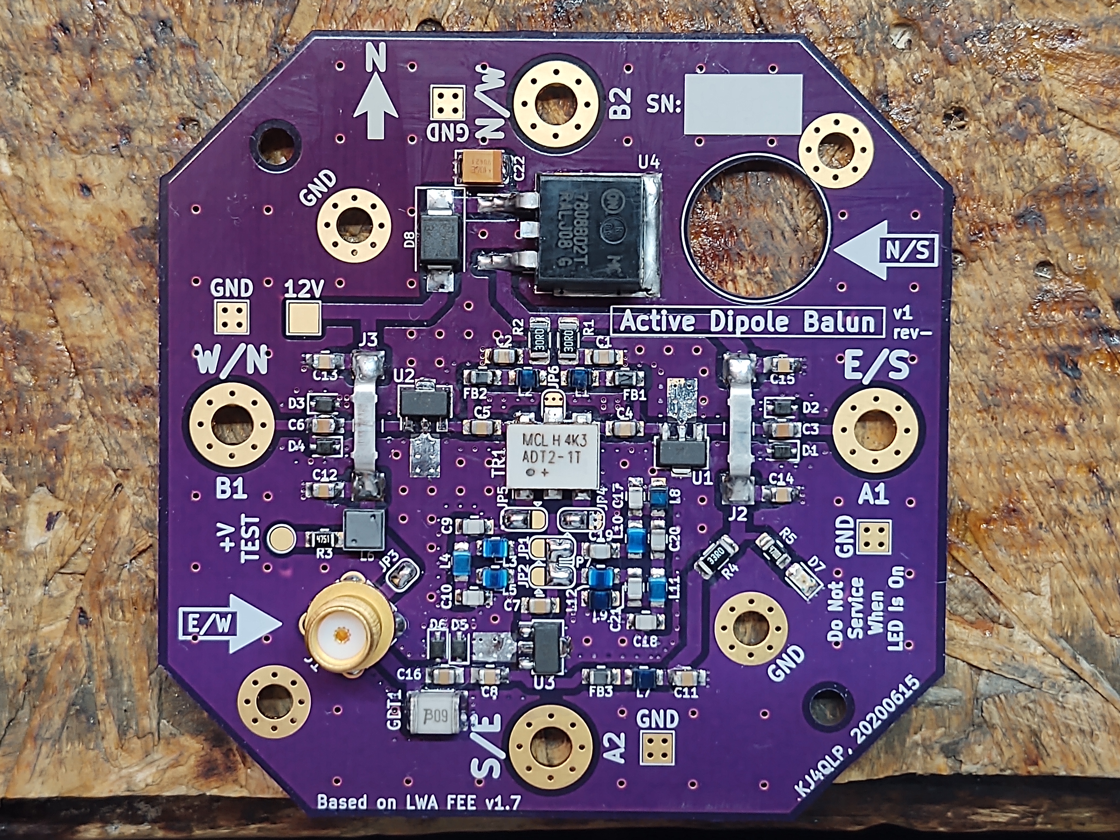
docs/hamsci_20200723/images/IMG_20200620_014855542.jpg
