zleffke/kicad_active_balun/docs/hamsci_20200723/images/Input_VSWR.png

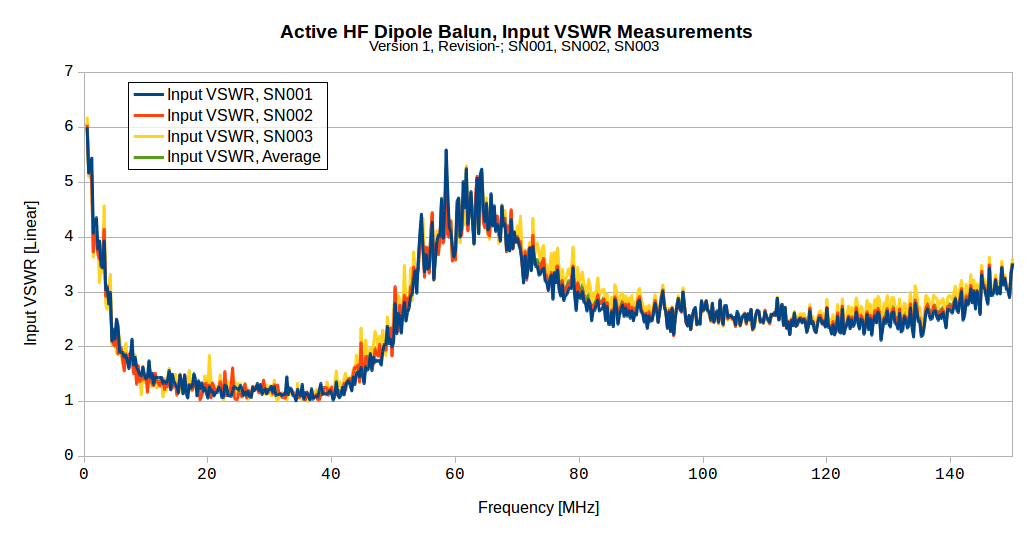
docs/hamsci_20200723/images/Input_VSWR.png
