zleffke/kicad_active_balun/docs/hamsci_20200723/images/noise_figure.png

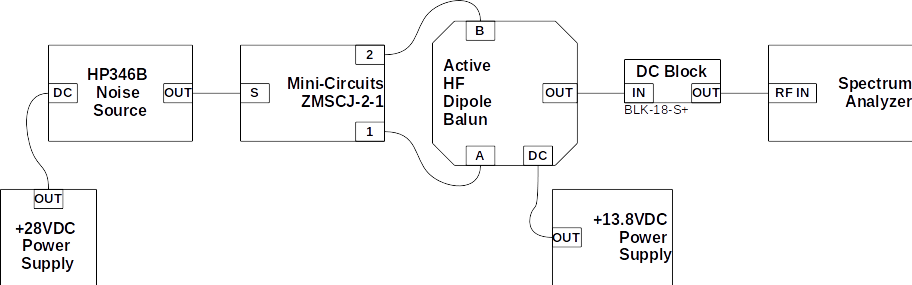
docs/hamsci_20200723/images/noise_figure.png
