zleffke/kicad_active_balun/docs/hamsci_20200723/images/osh_park_top_view.png

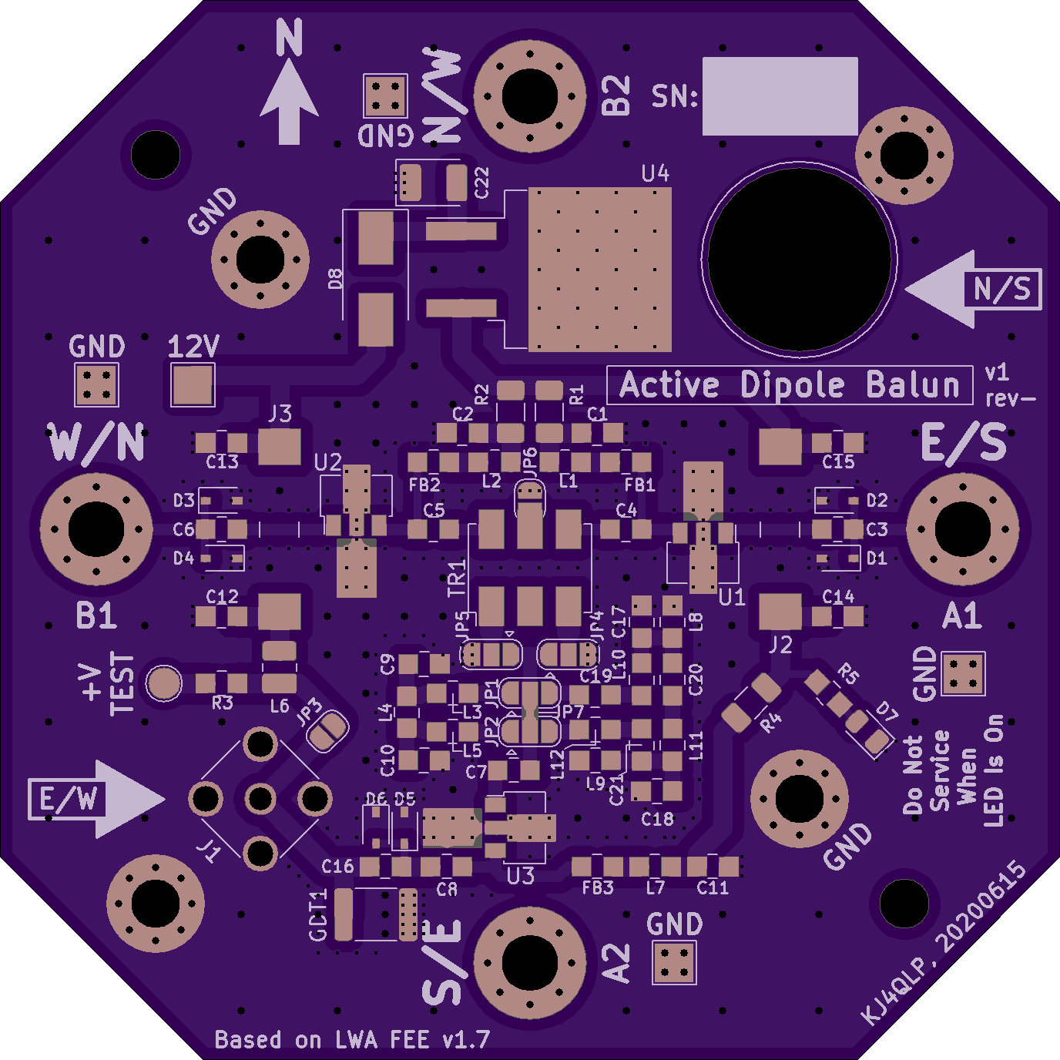
docs/hamsci_20200723/images/osh_park_top_view.png
