zleffke/kicad_active_balun/docs/hamsci_20200723/images/Output_VSWR.png

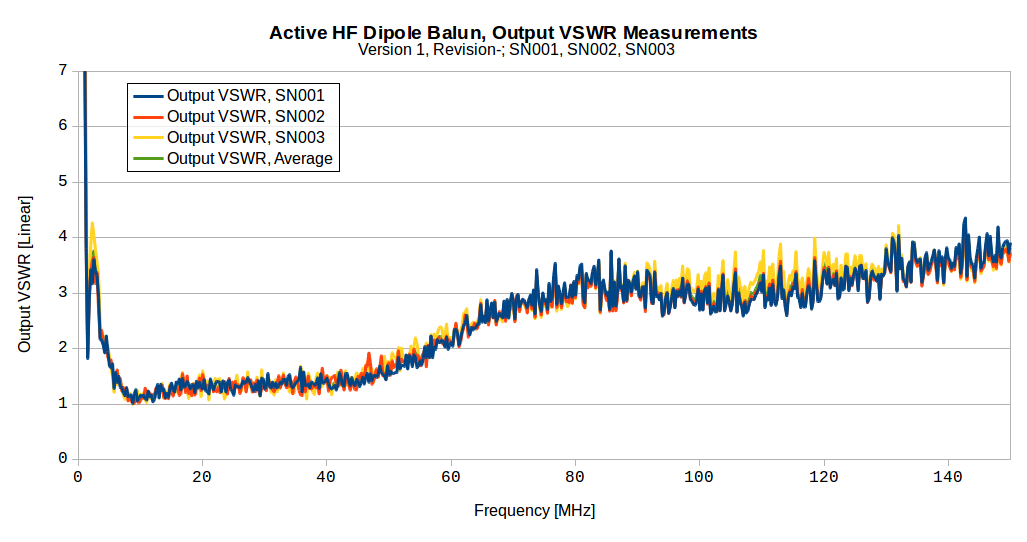
docs/hamsci_20200723/images/Output_VSWR.png
