zleffke/kicad_active_balun/docs/hamsci_20200723/images/P1dB_SN001.png

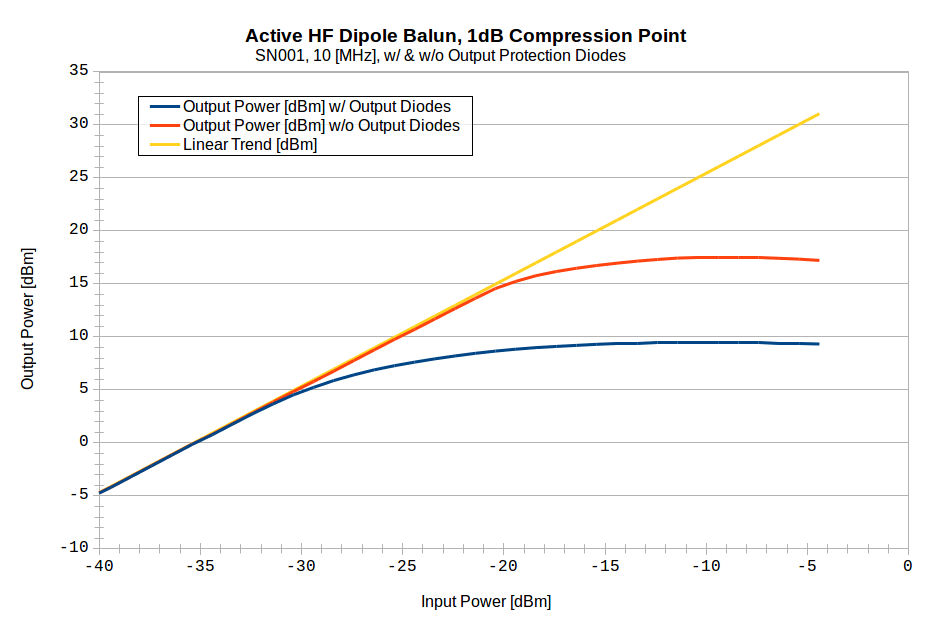
docs/hamsci_20200723/images/P1dB_SN001.png
