zleffke/kicad_active_balun/docs/hamsci_20200723/images/smt_hotplate.jpg

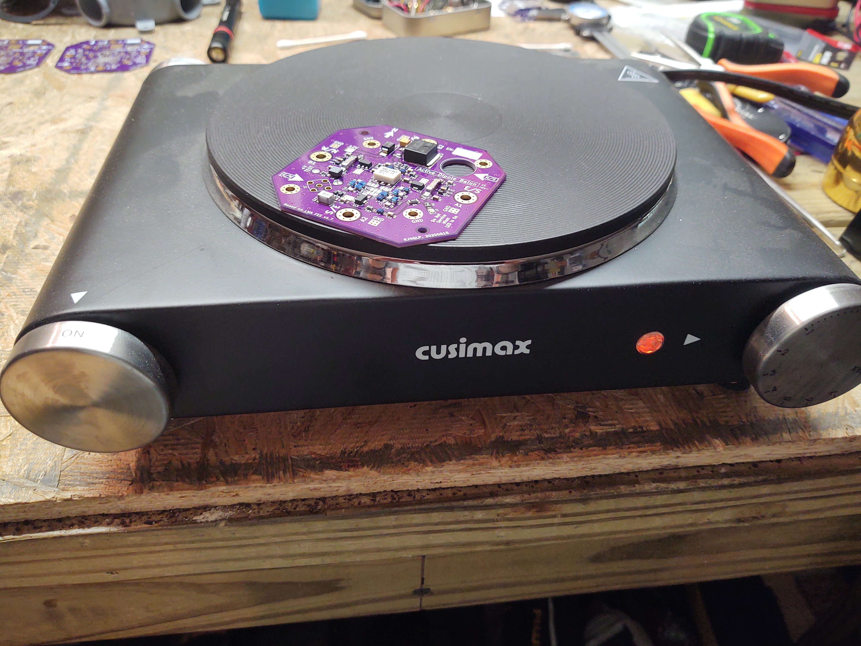
docs/hamsci_20200723/images/smt_hotplate.jpg
