zleffke/kicad_active_balun/docs/Initial Design/figures/meas_iip3.png

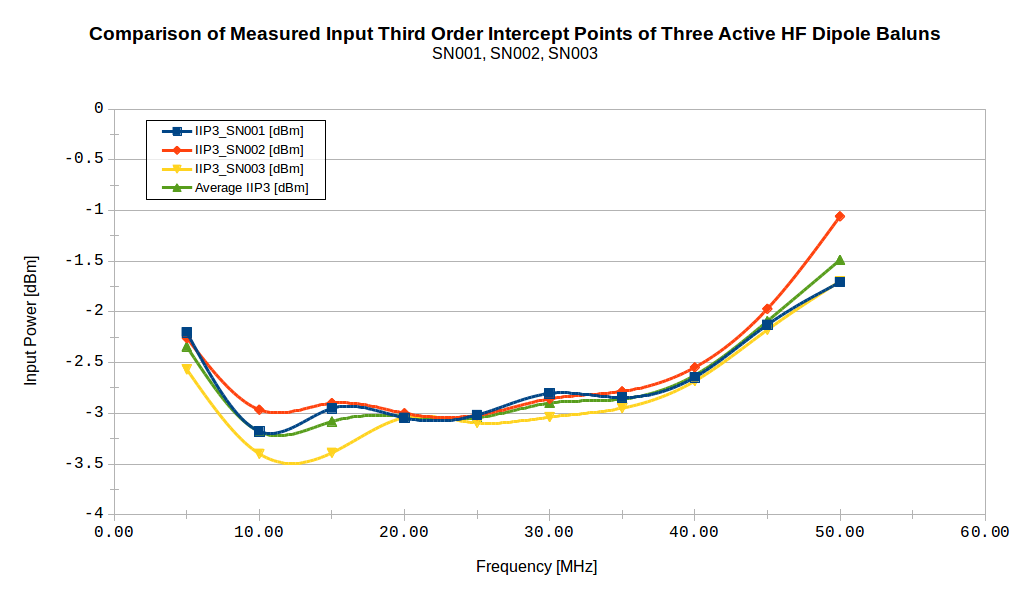
docs/Initial Design/figures/meas_iip3.png
