zleffke/kicad_active_balun/docs/Initial Design/figures/noise_figure.png

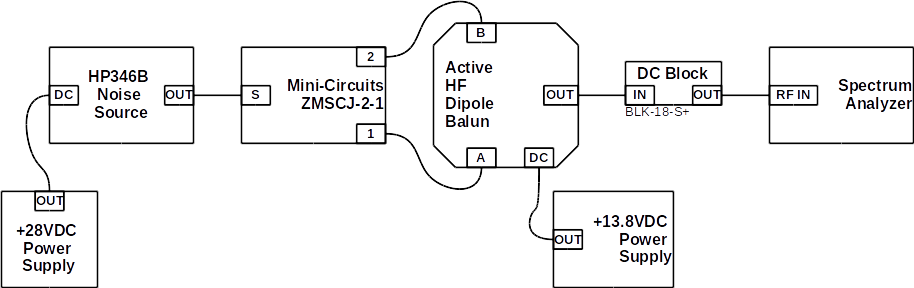
docs/Initial Design/figures/noise_figure.png
