zleffke/kicad_active_balun/docs/tapr-dcc_20200912/images/IMG_20200905_130309333.jpg

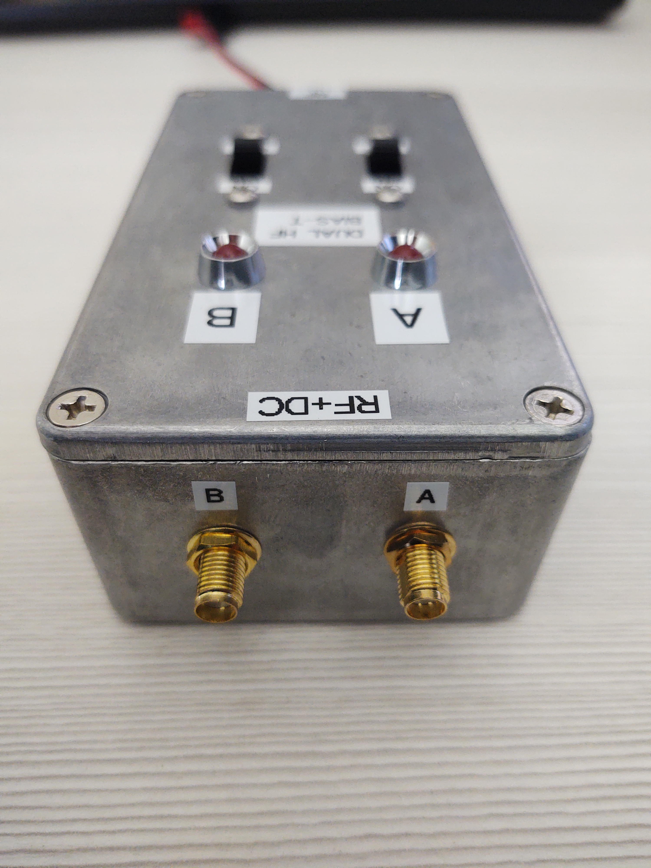
docs/tapr-dcc_20200912/images/IMG_20200905_130309333.jpg
