zleffke/kicad_active_balun/rf_meas/bench/active_balun_pga103_30ohm/noDiodes/noise_1MHz/N93XX_25.JPG

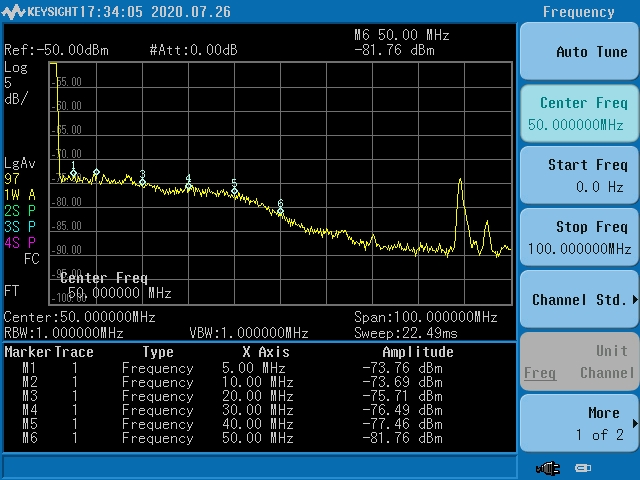
rf_meas/bench/active_balun_pga103_30ohm/noDiodes/noise_1MHz/N93XX_25.JPG
