zleffke/kicad_active_balun/rf_meas/bench/active_balun_sn001_39ohm/NoDiodes/meas_figures/Active_Balun_SN001_S21_Phase.png

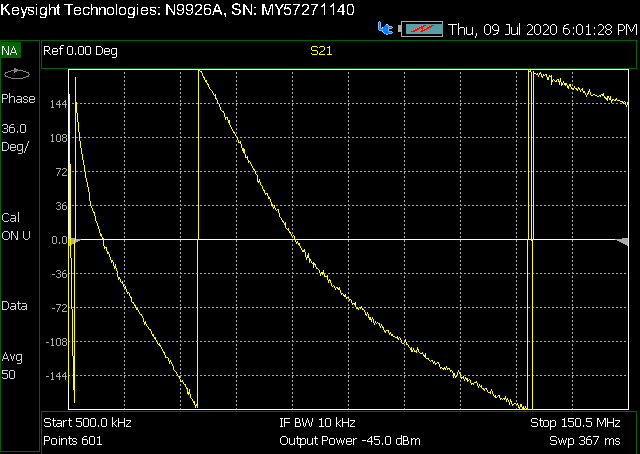
rf_meas/bench/active_balun_sn001_39ohm/NoDiodes/meas_figures/Active_Balun_SN001_S21_Phase.png
