zleffke/kicad_active_balun/rf_meas/bench/active_balun_sn001_39ohm/WithDiodes/noise_1MHz/NoiseSourceOff.JPG

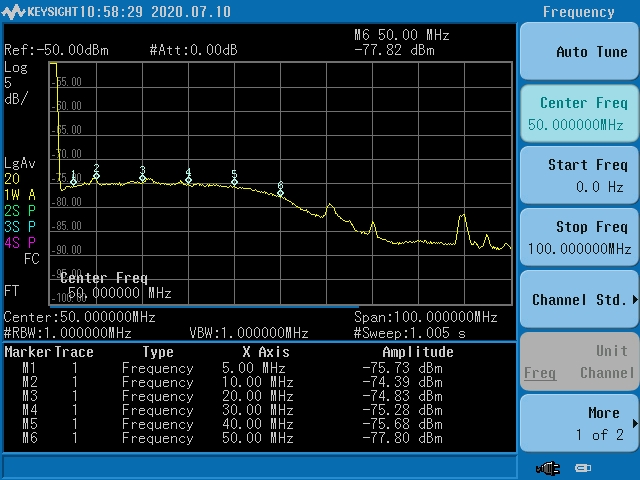
rf_meas/bench/active_balun_sn001_39ohm/WithDiodes/noise_1MHz/NoiseSourceOff.JPG
