zleffke/kicad_active_balun/rf_meas/bench/active_balun_sn002_39ohm/NoDiodes/meas_figures/Active_Balun_SN002_S12.png

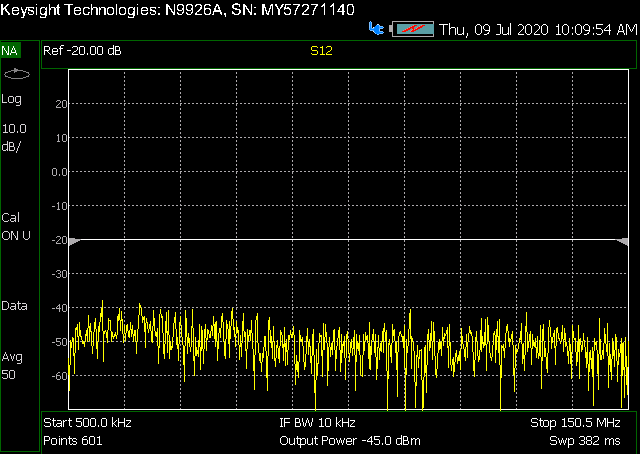
rf_meas/bench/active_balun_sn002_39ohm/NoDiodes/meas_figures/Active_Balun_SN002_S12.png
