zleffke/kicad_active_balun/rf_meas/bench/active_balun_sn003_39ohm/noDiodes/meas_figures/Active_Balun_SN003_S22.png

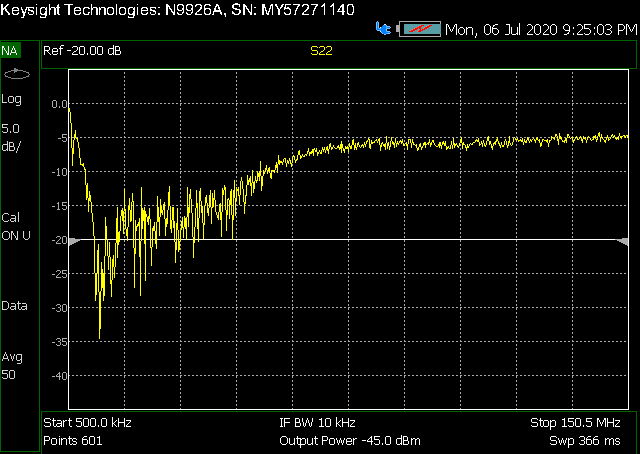
rf_meas/bench/active_balun_sn003_39ohm/noDiodes/meas_figures/Active_Balun_SN003_S22.png
