zleffke/kicad_active_balun/rf_meas/bench/active_balun_sn003_39ohm/noDiodes/noise_1MHz/NoiseSourceOff.JPG

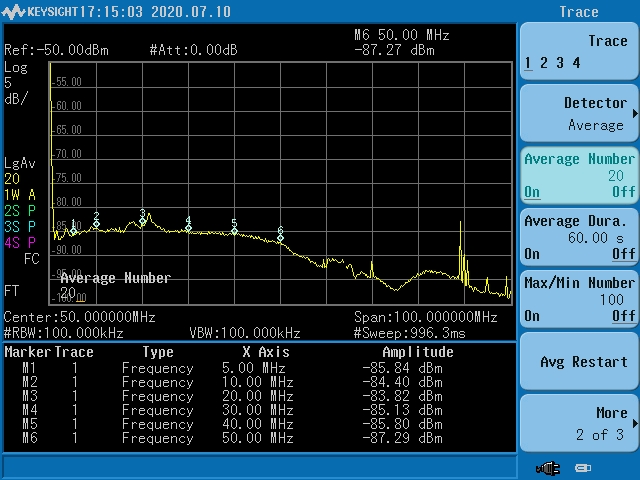
rf_meas/bench/active_balun_sn003_39ohm/noDiodes/noise_1MHz/NoiseSourceOff.JPG
