zleffke/kicad_active_balun/rf_meas/bench/active_balun_sn003_39ohm/withDiodes/meas_figures/Active_Balun_SN003_S22_VSWR.png

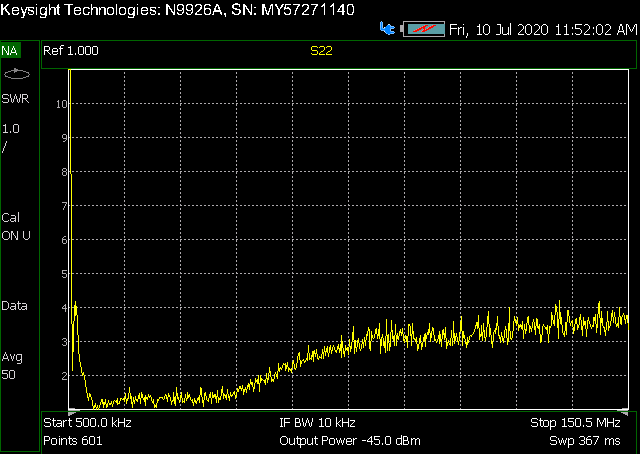
rf_meas/bench/active_balun_sn003_39ohm/withDiodes/meas_figures/Active_Balun_SN003_S22_VSWR.png
