zleffke/kicad_active_balun/rf_meas/bench/junk/active_balun_sn003_30ohm/WithDiodes/ACTIVE_BALUN_SN003_S11.png

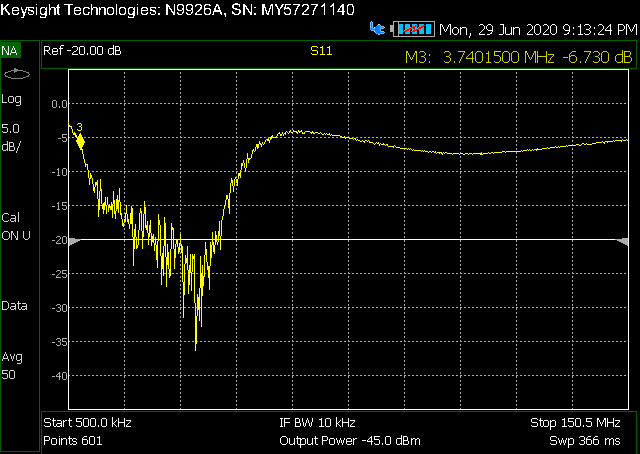
rf_meas/bench/junk/active_balun_sn003_30ohm/WithDiodes/ACTIVE_BALUN_SN003_S11.png
