zleffke/kicad_active_balun/rf_meas/bench/PGA103_VJB/8v_33ohm/noise_1MHz/ON.JPG

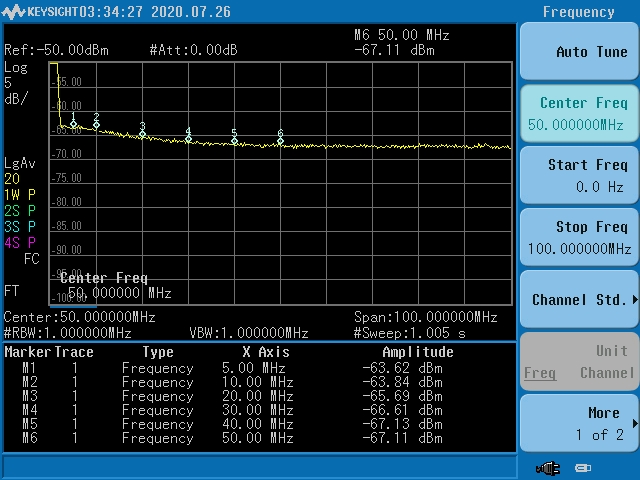
rf_meas/bench/PGA103_VJB/8v_33ohm/noise_1MHz/ON.JPG
