zleffke/kicad_active_balun/rf_meas/on_air/DXE-RF-PRO-1B_vs_AHFD/Screenshot from 2020-07-11 23-40-14.png

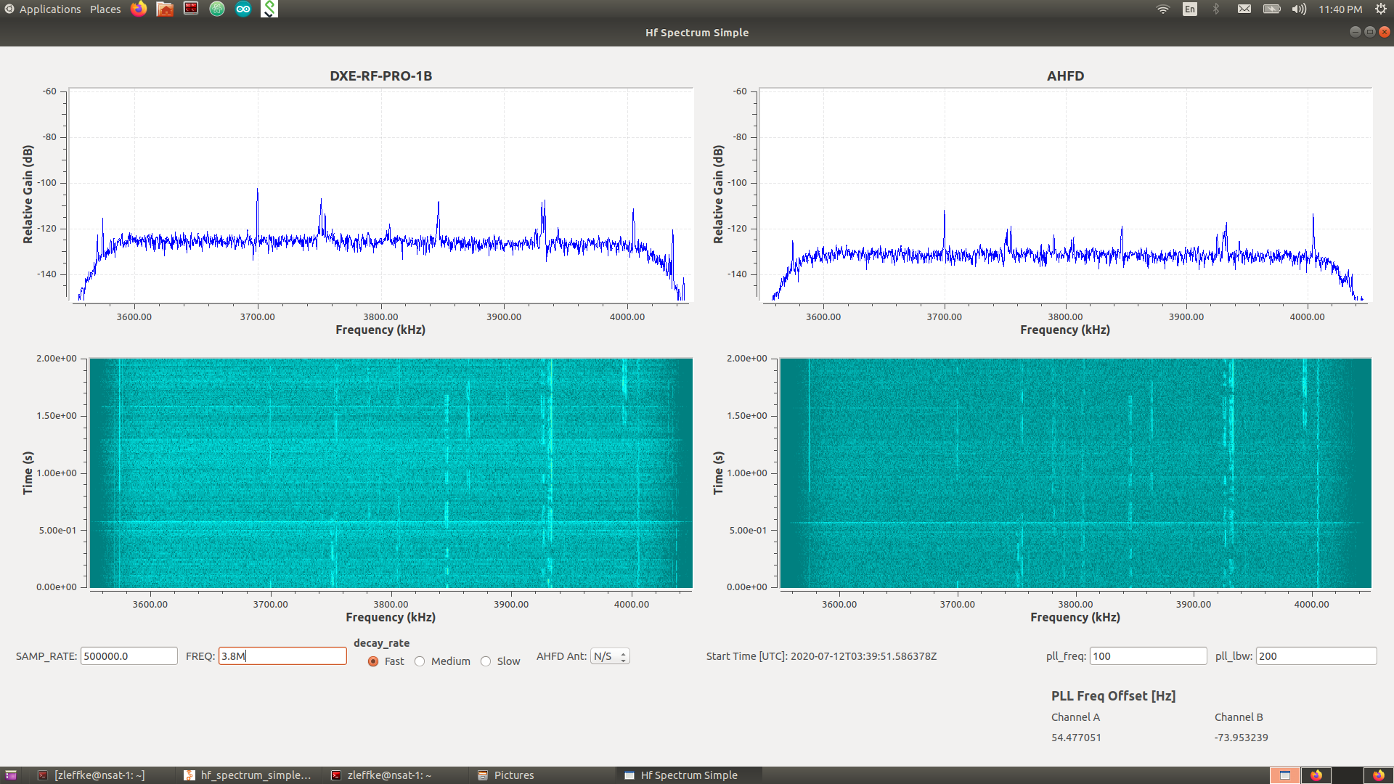
rf_meas/on_air/DXE-RF-PRO-1B_vs_AHFD/Screenshot from 2020-07-11 23-40-14.png
