zleffke/kicad_active_balun/rf_meas/on_air/T2FD_vs_AHFD/Screenshot from 2020-07-11 20-26-23.png

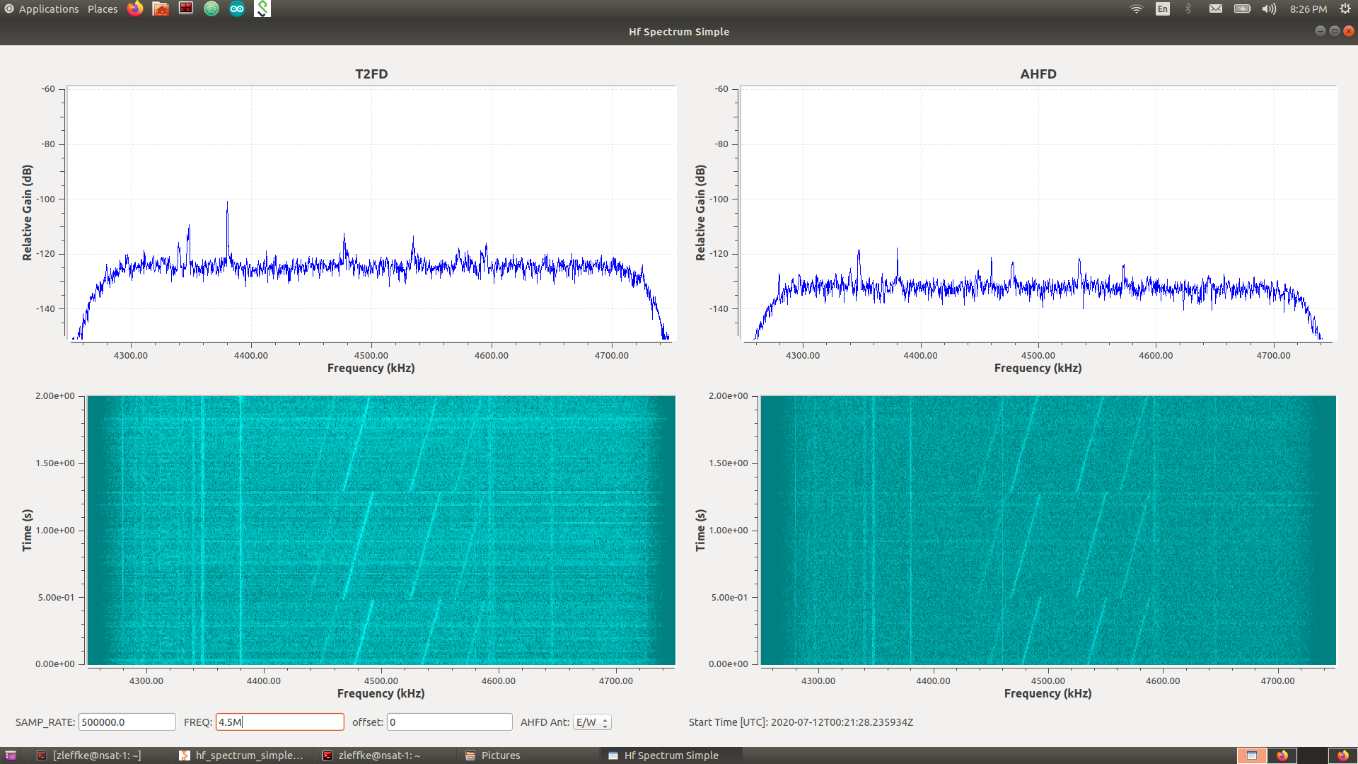
rf_meas/on_air/T2FD_vs_AHFD/Screenshot from 2020-07-11 20-26-23.png
