zleffke/kicad_active_balun/active_balun_v1/rev-/active_balun_v1_rev-_bom.ods

Sheet: single_pol_bom
Supplier | Part # | Supplier Description | U/L | Qty | Unit Cost | Total Cost | LINK | Board Identifier | Comment | Order Status
Digikey | 1N4148WSFSCT-ND | DIODE GEN PURP 75V 150MA SOD323F | ea | 6 | $0.16 | $0.96 | LINK (https://www.digikey.com/product-detail/en/on-semiconductor/1N4148WS/1N4148WSFSCT-ND/1873821) | D1 – D6 | ESD Protection Diodes
Digikey | MBRS2040LT3GOSCT-ND | Diode Schottky 40V 2A Surface Mount SMB | ea | 1 | $0.36 | $0.36 | LINK (https://www.digikey.com/product-detail/en/on-semiconductor/MBRS2040LT3G/MBRS2040LT3GOSCT-ND/918004) | D8 | Power protection diode, from LWA design
Digikey | 240-2396-1-ND | 2 kOhms @ 100MHz 1 Signal Line Ferrite Bead 0805 (2012 Metric) 300mA 500mOhm | ea | 3 | $0.10 | $0.30 | LINK (https://www.digikey.com/product-detail/en/laird-signal-integrity-products/HZ0805C202R-10/240-2396-1-ND/806756) | FB1-FB3 | Ferrite beads, MMIC Bias
Digikey | 399-5575-1-ND | 1000pF ±10% 630V Ceramic Capacitor X7R 0805 (2012 Metric) | ea | 2 | $0.55 | $1.10 | LINK (https://www.digikey.com/product-detail/en/kemet/C0805C102KBRACTU/399-5575-1-ND/2033937) | C3, C6 | RF Input caps. High voltage (lightning)
Digikey | 399-1168-1-ND | 0.1µF ±10% 25V Ceramic Capacitor X7R 0805 (2012 Metric) | ea | 12 | $0.10 | $1.25 | LINK (https://www.digikey.com/product-detail/en/kemet/C0805C104K3RACTU/399-1168-1-ND/411443) | C1,C2,C4,C5,C7,C8,C11-C16 | Bypass / DC block caps
Digikey | 478-5409-1-ND | 10µF Molded Tantalum Capacitors 25V 1411 (3528 Metric), 1210 1.8Ohm | ea | 1 | $0.80 | $0.80 | LINK (https://www.digikey.com/product-detail/en/avx-corporation/TPSB106M025R1800/478-5409-1-ND/1967713) | C22 | Vreg input cap
Digikey | 952-1474-1-ND | S1621-46R; 2 (1 x 2) Position Shunt Connector Non-Insulated 0.319" (8.10mm) Tin | ea | 2 | $0.24 | $0.48 | LINK (https://www.digikey.com/product-detail/en/harwin-inc/S1621-46R/952-1474-1-ND/2264560) | J2, J3 | SMT Power Jumpers
Digikey | PM1008S-4R7M-RCCT-ND | 4.7µH Shielded Wirewound Inductor 1A 350mOhm Max Nonstandard | ea | 1 | $0.87 | $0.87 | LINK (https://www.digikey.com/product-detail/en/bourns-inc/PM1008S-4R7M-RC/PM1008S-4R7M-RCCT-ND/6679649) | L6 | High Current Bias-T Inductor
Digikey | J500-ND | SMA Connector Jack, Female Socket 50Ohm Through Hole Solder | ea | 1 | $3.10 | $3.10 | LINK (https://www.digikey.com/product-detail/en/cinch-connectivity-solutions-johnson/142-0701-201/J500-ND/35274) | J1 | SMA Connector
Digikey | 2051-09-SM-RPLFCT-ND | Gas Discharge Tube 90V 2000A (2kA) ±30% 2 Pole Surface Mount, 1812 (4532 Metric) | ea | 1 | $0.79 | $0.79 | LINK (https://www.digikey.com/product-detail/en/bourns-inc/2051-09-SM-RPLF/2051-09-SM-RPLFCT-ND/2625123) | GDT1 | LWA Design uses 5kA version
Digikey | MC7808BD2TR4GOSCT-ND | IC REG LINEAR 8V 1A D2PAK; | ea | 1 | $0.85 | $0.85 | LINK (https://www.digikey.com/product-detail/en/on-semiconductor/MC7808BD2TR4G/MC7808BD2TR4GOSCT-ND/3487392) | U4 | 8V vreg
Digikey | 541-30.0UCT-ND | 30 Ohms ±1% 0.75W, 3/4W Chip Resistor 1206 (3216 Metric) Automotive AEC-Q200, Pulse Withstanding Thick Film | ea | 2 | $0.44 | $0.88 | LINK (https://www.digikey.com/product-detail/en/vishay-dale/CRCW120630R0FKEAHP/541-30-0UCT-ND/5326983) | R1, R2 | Gail-74 Bias resistor
Digikey | 541-33.0UCT-ND | 33 Ohms ±1% 0.75W, 3/4W Chip Resistor 1206 (3216 Metric) Automotive AEC-Q200, Pulse Withstanding Thick Film | ea | 1 | $0.44 | $0.44 | LINK (https://www.digikey.com/product-detail/en/vishay-dale/CRCW120633R0FKEAHP/541-33-0UCT-ND/2826112) | R4 | Gali-6 Bias resistor
Digikey | 311-470CRCT-ND | 470 Ohms ±1% 0.125W, 1/8W Chip Resistor 0805 (2012 Metric) Moisture Resistant Thick Film | ea | 1 | $0.10 | $0.10 | LINK (https://www.digikey.com/product-detail/en/yageo/RC0805FR-07470RL/311-470CRCT-ND/730923) | R5 | LED resistor
Digikey | 311-4.75KCRCT-ND | 4.75 kOhms ±1% 0.125W, 1/8W Chip Resistor 0805 (2012 Metric) Moisture Resistant Thick Film | ea | 1 | $0.10 | $0.10 | LINK (https://www.digikey.com/products/en/resistors/chip-resistor-surface-mount/52?k=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) | R3 | Test Voltage resistor
Digikey | 2035-0805CT-472EJFSCT-ND | 4.7µH Unshielded Wirewound Inductor 400mA 1.9Ohm 0805 (2012 Metric) | ea | 5 | $0.35 | $1.75 | LINK (https://www.digikey.com/product-detail/en/delta-electronics-components/0805CT-472EJFS/2035-0805CT-472EJFSCT-ND/10325621) | L1, L2, L7, L8, L9 | BPF Inductor / MMIC bias RFC
Digikey | 2035-1171-1-ND | 100nH Unshielded Wirewound Inductor 400mA 46mOhm 0805 (2012 Metric) | ea | 4 | $0.25 | $1.00 | LINK (https://www.digikey.com/product-detail/en/delta-electronics-components/0805CS-101EGTS/2035-1171-1-ND/10129404) | L3, L5, L10, L12 | BPF/LPF Inductor
Digikey | 2035-1247-1-ND | 330nH Unshielded Wirewound Inductor 310mA 1.4Ohm 0805 (2012 Metric) | ea | 2 | $0.25 | $0.50 | LINK (https://www.digikey.com/product-detail/en/delta-electronics-components/0805CS-331EGTS/2035-1247-1-ND/10129480) | L4, L11 | BPF/LPF Inductor
Digikey | 311-3379-1-ND | 100pF ±2% 50V Ceramic Capacitor C0G, NP0 0805 (2012 Metric) | ea | 4 | $0.21 | $0.84 | LINK (https://www.digikey.com/product-detail/en/yageo/CC0805GRNPO9BN101/311-3379-1-ND/6818349) | C9, C10, C17, C18 | BPF/LPF Capacitor
Digikey | 311-1832-1-ND | 4700pF ±5% 50V Ceramic Capacitor C0G, NP0 0805 (2012 Metric) | ea | 2 | $0.49 | $0.98 | LINK (https://www.digikey.com/product-detail/en/yageo/CC0805JKNPO9BN472/311-1832-1-ND/5195734) | C19, C21 | BPF Capacitor
Digikey | 311-4167-1-ND | 1500pF ±1% 50V Ceramic Capacitor C0G, NP0 0805 (2012 Metric) | ea | 1 | $0.57 | $0.57 | LINK (https://www.digikey.com/product-detail/en/yageo/CC0805FRNPO9BN152/311-4167-1-ND/8025256) | C20 | BPF Capacitor
Digikey | 754-1097-1-ND | Red 630nm LED Indication - Discrete 1.95V 0805 (2012 Metric) | ea | 1 | $0.44 | $0.44 | LINK (https://www.digikey.com/product-detail/en/kingbright/APHCM2012SURCK-F01/754-1097-1-ND/1747814) | D7
Mouser | 139-GALI-74 | GALI-74; SMT Low Noise Amplifier, DC - 1000 MHz, 50Ω; SOT-89 | ea | 2 | $4.28 | $8.56 | LINK (https://www.mouser.com/ProductDetail/Mini-Circuits/GALI-74%2B) | U1, U2 | Primary Active Device
Mouser | 139-GALI-6 | GALI-6+ SMT Gain Block, DC - 4000 MHz, 50Ω | ea | 1 | $3.24 | $3.24 | LINK (https://www.mouser.com/ProductDetail/Mini-Circuits/GALI-6%2B?qs=xZ%2FP%252Ba9zWqb5emXNudX23g%3D%3D) | U3 | Output Gain block
Mouser | 139-ADT2-1T | Audio Transformers / Signal Transformers RF XFMR / SURF MOUNT / RoHS; 1:2 CORE & WIRE Transformer, 0.4 - 450 MHz, 50Ω | ea | 1 | $5.77 | $5.77 | LINK (https://www.mouser.com/ProductDetail/Mini-Circuits/ADT2-1T%2B?qs=xZ%2FP%252Ba9zWqZ82IRhU0SXxQ%3D%3D) | TR1 | RF Transformer / Balun; covers lower range
 |  |  |  |  | Subtotal | $36.03

Sheet: dual_pol_bom
Supplier | Part # | Supplier Description | U/L | Qty | Unit Cost | Total Cost | LINK | Board Identifier | Comment | Order Status
Digikey | 1N4148WSFSCT-ND | DIODE GEN PURP 75V 150MA SOD323F | ea | 12 | $0.15 | $1.76 | LINK (https://www.digikey.com/product-detail/en/on-semiconductor/1N4148WS/1N4148WSFSCT-ND/1873821) | D1 – D6 | ESD Protection Diodes
Digikey | MBRS2040LT3GOSCT-ND | Diode Schottky 40V 2A Surface Mount SMB | ea | 2 | $0.36 | $0.72 | LINK (https://www.digikey.com/product-detail/en/on-semiconductor/MBRS2040LT3G/MBRS2040LT3GOSCT-ND/918004) | D8 | Power protection diode, from LWA design
Digikey | 240-2396-1-ND | 2 kOhms @ 100MHz 1 Signal Line Ferrite Bead 0805 (2012 Metric) 300mA 500mOhm | ea | 6 | $0.10 | $0.60 | LINK (https://www.digikey.com/product-detail/en/laird-signal-integrity-products/HZ0805C202R-10/240-2396-1-ND/806756) | FB1-FB3 | Ferrite beads, MMIC Bias
Digikey | 399-5575-1-ND | 1000pF ±10% 630V Ceramic Capacitor X7R 0805 (2012 Metric) | ea | 4 | $0.55 | $2.20 | LINK (https://www.digikey.com/product-detail/en/kemet/C0805C102KBRACTU/399-5575-1-ND/2033937) | C3, C6 | RF Input caps. High voltage (lightning)
Digikey | 399-1168-1-ND | 0.1µF ±10% 25V Ceramic Capacitor X7R 0805 (2012 Metric) | ea | 24 | $0.10 | $2.50 | LINK (https://www.digikey.com/product-detail/en/kemet/C0805C104K3RACTU/399-1168-1-ND/411443) | C1,C2,C4,C5,C7,C8,C11-C16 | Bypass / DC block caps
Digikey | 478-5409-1-ND | 10µF Molded Tantalum Capacitors 25V 1411 (3528 Metric), 1210 1.8Ohm | ea | 2 | $0.80 | $1.60 | LINK (https://www.digikey.com/product-detail/en/avx-corporation/TPSB106M025R1800/478-5409-1-ND/1967713) | C22 | Vreg input cap
Digikey | 952-1474-1-ND | S1621-46R; 2 (1 x 2) Position Shunt Connector Non-Insulated 0.319" (8.10mm) Tin | ea | 4 | $0.24 | $0.96 | LINK (https://www.digikey.com/product-detail/en/harwin-inc/S1621-46R/952-1474-1-ND/2264560) | J2, J3 | SMT Power Jumpers
Digikey | PM1008S-4R7M-RCCT-ND | 4.7µH Shielded Wirewound Inductor 1A 350mOhm Max Nonstandard | ea | 2 | $0.87 | $1.74 | LINK (https://www.digikey.com/product-detail/en/bourns-inc/PM1008S-4R7M-RC/PM1008S-4R7M-RCCT-ND/6679649) | L6 | High Current Bias-T Inductor
Digikey | J500-ND | SMA Connector Jack, Female Socket 50Ohm Through Hole Solder | ea | 2 | $3.10 | $6.20 | LINK (https://www.digikey.com/product-detail/en/cinch-connectivity-solutions-johnson/142-0701-201/J500-ND/35274) | J1 | SMA Connector
Digikey | 2051-09-SM-RPLFCT-ND | Gas Discharge Tube 90V 2000A (2kA) ±30% 2 Pole Surface Mount, 1812 (4532 Metric) | ea | 2 | $0.79 | $1.58 | LINK (https://www.digikey.com/product-detail/en/bourns-inc/2051-09-SM-RPLF/2051-09-SM-RPLFCT-ND/2625123) | GDT1 | LWA Design uses 5kA version
Digikey | MC7808BD2TR4GOSCT-ND | IC REG LINEAR 8V 1A D2PAK; | ea | 2 | $0.85 | $1.70 | LINK (https://www.digikey.com/product-detail/en/on-semiconductor/MC7808BD2TR4G/MC7808BD2TR4GOSCT-ND/3487392) | U4 | 8V vreg
Digikey | 541-30.0UCT-ND | 30 Ohms ±1% 0.75W, 3/4W Chip Resistor 1206 (3216 Metric) Automotive AEC-Q200, Pulse Withstanding Thick Film | ea | 4 | $0.44 | $1.76 | LINK (https://www.digikey.com/product-detail/en/vishay-dale/CRCW120630R0FKEAHP/541-30-0UCT-ND/5326983) | R1, R2 | Gail-74 Bias resistor
Digikey | 541-33.0UCT-ND | 33 Ohms ±1% 0.75W, 3/4W Chip Resistor 1206 (3216 Metric) Automotive AEC-Q200, Pulse Withstanding Thick Film | ea | 2 | $0.44 | $0.88 | LINK (https://www.digikey.com/product-detail/en/vishay-dale/CRCW120633R0FKEAHP/541-33-0UCT-ND/2826112) | R4 | Gali-6 Bias resistor
Digikey | 311-470CRCT-ND | 470 Ohms ±1% 0.125W, 1/8W Chip Resistor 0805 (2012 Metric) Moisture Resistant Thick Film | ea | 2 | $0.10 | $0.20 | LINK (https://www.digikey.com/product-detail/en/yageo/RC0805FR-07470RL/311-470CRCT-ND/730923) | R5 | LED resistor
Digikey | 311-4.75KCRCT-ND | 4.75 kOhms ±1% 0.125W, 1/8W Chip Resistor 0805 (2012 Metric) Moisture Resistant Thick Film | ea | 2 | $0.10 | $0.20 | LINK (https://www.digikey.com/products/en/resistors/chip-resistor-surface-mount/52?k=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) | R3 | Test Voltage resistor
Digikey | 2035-0805CT-472EJFSCT-ND | 4.7µH Unshielded Wirewound Inductor 400mA 1.9Ohm 0805 (2012 Metric) | ea | 10 | $0.28 | $2.77 | LINK (https://www.digikey.com/product-detail/en/delta-electronics-components/0805CT-472EJFS/2035-0805CT-472EJFSCT-ND/10325621) | L1, L2, L7, L8, L9 | BPF Inductor / MMIC bias RFC
Digikey | 2035-1171-1-ND | 100nH Unshielded Wirewound Inductor 400mA 46mOhm 0805 (2012 Metric) | ea | 8 | $0.25 | $2.00 | LINK (https://www.digikey.com/product-detail/en/delta-electronics-components/0805CS-101EGTS/2035-1171-1-ND/10129404) | L3, L5, L10, L12 | BPF/LPF Inductor
Digikey | 2035-1247-1-ND | 330nH Unshielded Wirewound Inductor 310mA 1.4Ohm 0805 (2012 Metric) | ea | 4 | $0.25 | $1.00 | LINK (https://www.digikey.com/product-detail/en/delta-electronics-components/0805CS-331EGTS/2035-1247-1-ND/10129480) | L4, L11 | BPF/LPF Inductor
Digikey | 311-3379-1-ND | 100pF ±2% 50V Ceramic Capacitor C0G, NP0 0805 (2012 Metric) | ea | 8 | $0.21 | $1.68 | LINK (https://www.digikey.com/product-detail/en/yageo/CC0805GRNPO9BN101/311-3379-1-ND/6818349) | C9, C10, C17, C18 | BPF/LPF Capacitor
Digikey | 311-1832-1-ND | 4700pF ±5% 50V Ceramic Capacitor C0G, NP0 0805 (2012 Metric) | ea | 4 | $0.49 | $1.96 | LINK (https://www.digikey.com/product-detail/en/yageo/CC0805JKNPO9BN472/311-1832-1-ND/5195734) | C19, C21 | BPF Capacitor
Digikey | 311-4167-1-ND | 1500pF ±1% 50V Ceramic Capacitor C0G, NP0 0805 (2012 Metric) | ea | 2 | $0.57 | $1.14 | LINK (https://www.digikey.com/product-detail/en/yageo/CC0805FRNPO9BN152/311-4167-1-ND/8025256) | C20 | BPF Capacitor
Digikey | 754-1097-1-ND | Red 630nm LED Indication - Discrete 1.95V 0805 (2012 Metric) | ea | 2 | $0.44 | $0.88 | LINK (https://www.digikey.com/product-detail/en/kingbright/APHCM2012SURCK-F01/754-1097-1-ND/1747814) | D7
Mouser | 139-GALI-74 | GALI-74; SMT Low Noise Amplifier, DC - 1000 MHz, 50Ω; SOT-89 | ea | 4 | $4.28 | $17.12 | LINK (https://www.mouser.com/ProductDetail/Mini-Circuits/GALI-74%2B) | U1, U2 | Primary Active Device
Mouser | 139-GALI-6 | GALI-6+ SMT Gain Block, DC - 4000 MHz, 50Ω | ea | 2 | $3.24 | $6.48 | LINK (https://www.mouser.com/ProductDetail/Mini-Circuits/GALI-6%2B?qs=xZ%2FP%252Ba9zWqb5emXNudX23g%3D%3D) | U3 | Output Gain block
Mouser | 139-ADT2-1T | Audio Transformers / Signal Transformers RF XFMR / SURF MOUNT / RoHS; 1:2 CORE & WIRE Transformer, 0.4 - 450 MHz, 50Ω | ea | 2 | $5.77 | $11.54 | LINK (https://www.mouser.com/ProductDetail/Mini-Circuits/ADT2-1T%2B?qs=xZ%2FP%252Ba9zWqZ82IRhU0SXxQ%3D%3D) | TR1 | RF Transformer / Balun; covers lower range
 |  |  |  |  | Subtotal | $71.17
