zleffke/kicad_active_balun/docs/hamsci_20200723/images/assemble_hub.jpg

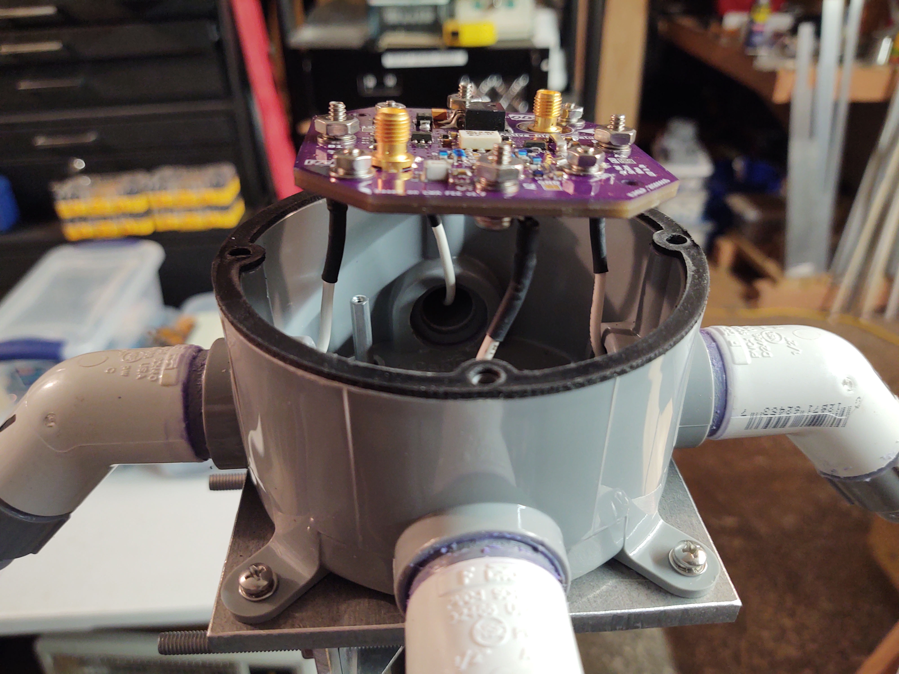
docs/hamsci_20200723/images/assemble_hub.jpg
