zleffke/kicad_active_balun/docs/hamsci_20200723/images/assemble_lid.jpg

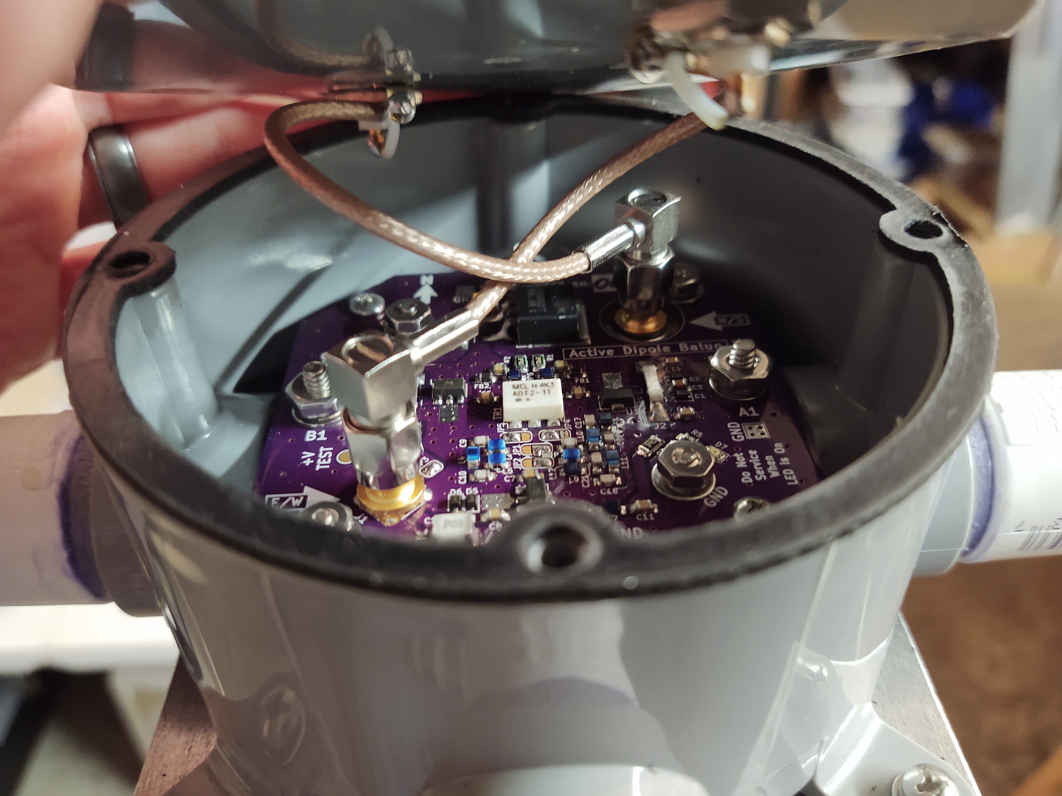
docs/hamsci_20200723/images/assemble_lid.jpg
