zleffke/kicad_active_balun/docs/hamsci_20200723/images/sdr_setup.jpg

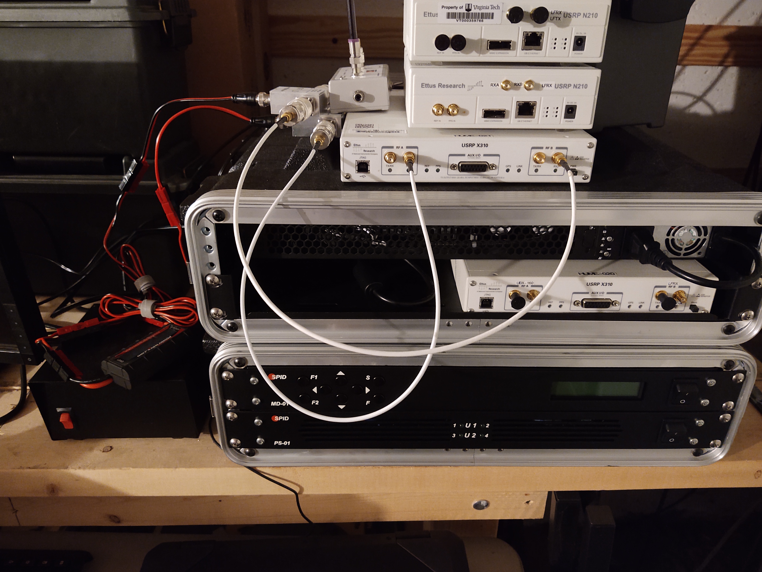
docs/hamsci_20200723/images/sdr_setup.jpg
