zleffke/kicad_active_balun/rf_meas/bench/Calibration/noise_enviro_cal/readme.txt

N93XX_24.jpg - 
10dB / div, Ethernet Switch on, trace detector - pos peak, no averaging
ref lvl: -40 dBm, attn = 0 dB

N93XX_25.jpg:
5 dB/div, Ethernet Switch On, trace detector - pos peak, no averaging
ref lvl: -70 dBm, attn = 0 dB

N1E.csv:
Noise, active balun SN001, trace detector pos peak, no averaging
ref lvl -40 dBm

N1E_2.csv/ods:
Noise, active balun SN001, trace detector pos peak, no averaging
ref lvl -70 dBm
