zleffke/kicad_active_balun/docs/Initial Design/sections/measurement.tex

\newpage
\section{Measurement}

\label{sec:measurement}

\subsection{Performance Metrics Definition}
\label{subsec:meas_desc}

\subsection{Measurement Results}
\label{subsec:meas_results}

Version 1, Revision - (pronounced `rev dash') \\
\noindent Serial Number Tested: 003
