zleffke/kicad_active_balun/rf_meas/bench/Calibration/FW-10+_Attn_S21.csv

! FILETYPE CSV
! VERSION 2.0 | 1
! TIMESTAMP Saturday | 04 July 2020 12:53:48
! TIMEZONE
! NAME Keysight Technologies
! MODEL N9926A
! SERIAL MY57271140
! FIRMWARE_VERSION A.10.18
! VF | 1.000
! Media | Coax
! IF_BW | 10000
! Output_Power_Mode | MAN
! Output_Power_Level | -45
! GPS_LATITUDE
! GPS_LONGITUDE
! GPS_TIMESTAMP 0001-01-01 00:00:00Z
! GPS_SECS_SINCE_LAST_READ 0
! CHECKSUM 0360512354
! CORRECTION1 ON U
! DATA Freq | S21
! FREQ UNIT Hz
! DATA UNIT dB
BEGIN
500000 | -9.97297867473861
750000 | -10.3247011095622
1000000 | -10.6376480369693
1250000 | -10.1184522236946
1500000 | -10.0761187537092
1750000 | -10.3019703469985
2000000 | -10.2316266508717
2250000 | -10.1704833678807
2500000 | -10.4590399761803
2750000 | -10.1719565908355
3000000 | -10.1440012814744
3250000 | -10.0585795612918
3500000 | -10.2514294573532
3750000 | -10.332479488592
4000000 | -9.87311490498859
4250000 | -10.4566945999237
4500000 | -10.2282174733603
4750000 | -10.0257371793896
5000000 | -10.0286535366382
5250000 | -10.5873548987856
5500000 | -10.5112068293062
5750000 | -10.2834784303204
6000000 | -10.109004624745
6250000 | -10.3308565696713
6500000 | -10.0971593888189
6750000 | -10.1120334966913
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
