zleffke/kicad_active_balun/rf_meas/bench/Calibration/FW-20+_Attn_S21.csv

! FILETYPE CSV
! VERSION 2.0 | 1
! TIMESTAMP Saturday | 04 July 2020 13:06:56
! TIMEZONE
! NAME Keysight Technologies
! MODEL N9926A
! SERIAL MY57271140
! FIRMWARE_VERSION A.10.18
! VF | 1.000
! Media | Coax
! IF_BW | 10000
! Output_Power_Mode | MAN
! Output_Power_Level | -45
! GPS_LATITUDE
! GPS_LONGITUDE
! GPS_TIMESTAMP 0001-01-01 00:00:00Z
! GPS_SECS_SINCE_LAST_READ 0
! CHECKSUM 0163407243
! CORRECTION1 ON U
! DATA Freq | S21
! FREQ UNIT Hz
! DATA UNIT dB
BEGIN
500000 | -19.977595917431
750000 | -20.3910277676787
1000000 | -20.9959263153697
1250000 | -20.0375694433456
1500000 | -20.1841394949679
1750000 | -20.2938702720643
2000000 | -20.4333941093069
2250000 | -19.8570110625683
2500000 | -20.5643037581024
2750000 | -20.0427125523513
3000000 | -20.1418191586995
3250000 | -20.2794585430404
3500000 | -20.5704576445445
3750000 | -20.136596725752
4000000 | -19.7564489015259
4250000 | -20.4024285012913
4500000 | -20.2522983042077
4750000 | -19.7984136272142
5000000 | -19.9025824398974
5250000 | -20.7663624599876
5500000 | -20.4783615209204
5750000 | -19.7772981883864
6000000 | -19.6966481436002
6250000 | -20.6795355456821
6500000 | -19.815752135825
6750000 | -19.7172123883972
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
