zleffke/kicad_active_balun/rf_meas/bench/Calibration/SMA_Barrel_S21.csv

! FILETYPE CSV
! VERSION 2.0 | 1
! TIMESTAMP Saturday | 04 July 2020 12:52:19
! TIMEZONE
! NAME Keysight Technologies
! MODEL N9926A
! SERIAL MY57271140
! FIRMWARE_VERSION A.10.18
! VF | 1.000
! Media | Coax
! IF_BW | 10000
! Output_Power_Mode | MAN
! Output_Power_Level | -45
! GPS_LATITUDE
! GPS_LONGITUDE
! GPS_TIMESTAMP 0001-01-01 00:00:00Z
! GPS_SECS_SINCE_LAST_READ 0
! CHECKSUM 0086492225
! CORRECTION1 ON U
! DATA Freq | S21
! FREQ UNIT Hz
! DATA UNIT dB
BEGIN
500000 | 0.0924372311062033
750000 | -0.295091190909074
1000000 | -0.59765577848807
1250000 | -0.0538166497727471
1500000 | -0.13224643425594
1750000 | -0.227099135365727
2000000 | -0.148989348249246
2250000 | -0.221932097787468
2500000 | -0.432287859982578
2750000 | -0.0550831488698533
3000000 | -0.117332155616163
3250000 | -0.0886735023312938
3500000 | -0.277553836895117
3750000 | -0.167885182881334
4000000 | -0.0361316012362628
4250000 | -0.333316206532191
4500000 | -0.222646123137414
4750000 | 0.0830664147855674
5000000 | 0.00815553004350919
5250000 | -0.609420024198604
5500000 | -0.381718503113909
5750000 | -0.319948157020382
6000000 | -0.0207103616778779
6250000 | -0.45820556306824
6500000 | -0.000989019233759065
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
