zleffke/kicad_active_balun/rf_meas/bench/active_balun_pga103_30ohm/withDiodes/Active_Balun_PGA103_30Ohm_WithDiodes_Measurements.ods

Sheet: Active_Balun_PGA103_30Ohm_S11
! FILETYPE CSV
! VERSION 2.0 | 1
! TIMESTAMP Saturday | 25 July 2020 18:28:14
! TIMEZONE
! NAME Keysight Technologies
! MODEL N9926A
! SERIAL MY57271140
! FIRMWARE_VERSION A.10.18
! VF | 1
! Media | Coax
! IF_BW | 10000
! Output_Power_Mode | MAN
! Output_Power_Level | -45
! GPS_LATITUDE
! GPS_LONGITUDE
! GPS_TIMESTAMP 0001-01-01 00:00:00Z
! GPS_SECS_SINCE_LAST_READ 0
! CHECKSUM 0829204099
! CORRECTION1 ON U
! DATA Freq | S11
! FREQ UNIT Hz
! DATA UNIT dB
BEGIN
500000 | -2.635475084
750000 | -2.8348659798
1000000 | -2.4691408479
1250000 | -1.7572597846
1500000 | -2.3178622602
1750000 | -2.5313277997
2000000 | -1.8014921184
2250000 | -3.3931009658
2500000 | -2.0219042838
2750000 | -1.3444833097
3000000 | -1.1111376964
3250000 | -3.1803783837
3500000 | -2.1274547805
3750000 | -0.9694177482
4000000 | -1.7539469888
4250000 | -1.011564886
4500000 | -1.4299257411
4750000 | -2.7938999827
5000000 | -1.5743040757
5250000 | -1.5423272618
5500000 | -1.9713501451
5750000 | -1.7053867119
6000000 | -1.0648327609
6250000 | -3.148568116
6500000 | -2.1878224122
6750000 | -1.3652491929
7000000 | -2.1204025025
7250000 | -0.1210182209
7500000 | -2.8402108925
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
