zleffke/kicad_active_balun/rf_meas/bench/active_balun_sn001_39ohm/NoDiodes/Active_Balun_SN001_NoDiodes_Measurements.ods

Sheet: Active_Balun_SN001_S11
! FILETYPE CSV
! VERSION 2.0 | 1
! TIMESTAMP Tuesday | 07 July 2020 23:12:46
! TIMEZONE
! NAME Keysight Technologies
! MODEL N9926A
! SERIAL MY57271140
! FIRMWARE_VERSION A.10.18
! VF | 1
! Media | Coax
! IF_BW | 10000
! Output_Power_Mode | MAN
! Output_Power_Level | -45
! GPS_LATITUDE
! GPS_LONGITUDE
! GPS_TIMESTAMP 0001-01-01 00:00:00Z
! GPS_SECS_SINCE_LAST_READ 0
! CHECKSUM 1150832644
! CORRECTION1 ON U
! DATA Freq | S11
! FREQ UNIT Hz
! DATA UNIT dB
BEGIN
500000 | -2.9565984049
750000 | -3.4153296434
1000000 | -3.4082683516
1250000 | -3.2912917845
1500000 | -4.2319844123
1750000 | -4.3957793972
2000000 | -4.4302629798
2250000 | -4.6819525285
2500000 | -4.8977366743
2750000 | -4.6777210034
3000000 | -4.4266550249
3250000 | -4.3655731802
3500000 | -5.7894112375
3750000 | -6.2065647652
4000000 | -6.4720095556
4250000 | -6.3901807505
4500000 | -7.9803340918
4750000 | -7.3317415335
5000000 | -8.410172735
5250000 | -7.6656270123
5500000 | -9.7052226709
5750000 | -8.9370005358
6000000 | -11.242186145
6250000 | -9.4104883244
6500000 | -10.1111745621
6750000 | -8.4558365573
7000000 | -11.6823834531
7250000 | -9.539658155
7500000 | -9.1667790718
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
