zleffke/kicad_active_balun/rf_meas/bench/active_balun_sn001_39ohm/WithDiodes/Active_Balun_SN001_WithDiodes_Measurements.ods

Sheet: Active_Balun_SN001_S11
! FILETYPE CSV
! VERSION 2.0 | 1
! TIMESTAMP Tuesday | 07 July 2020 21:14:43
! TIMEZONE
! NAME Keysight Technologies
! MODEL N9926A
! SERIAL MY57271140
! FIRMWARE_VERSION A.10.18
! VF | 1
! Media | Coax
! IF_BW | 10000
! Output_Power_Mode | MAN
! Output_Power_Level | -45
! GPS_LATITUDE
! GPS_LONGITUDE
! GPS_TIMESTAMP 0001-01-01 00:00:00Z
! GPS_SECS_SINCE_LAST_READ 0
! CHECKSUM 0809277951
! CORRECTION1 ON U
! DATA Freq | S11
! FREQ UNIT Hz
! DATA UNIT dB
BEGIN
500000 | -2.9330150693
750000 | -3.3831917005
1000000 | -3.2518402831
1250000 | -3.3274598755
1500000 | -4.4612625049
1750000 | -4.0028618095
2000000 | -4.3237324727
2250000 | -4.589956997
2500000 | -4.9422052144
2750000 | -4.8493918093
3000000 | -4.5193704324
3250000 | -4.2633370965
3500000 | -6.2301615211
3750000 | -5.402356275
4000000 | -6.1732297566
4250000 | -7.057626683
4500000 | -8.0828457081
4750000 | -7.2837047224
5000000 | -8.5399834825
5250000 | -7.4078643441
5500000 | -8.772786984
5750000 | -8.9721592192
6000000 | -11.7336454532
6250000 | -8.947470084
6500000 | -10.7624411664
6750000 | -9.3150582256
7000000 | -11.4311055371
7250000 | -11.2346794336
7500000 | -14.3336603073
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
