zleffke/kicad_active_balun/rf_meas/bench/active_balun_sn002_39ohm/NoDiodes/Active_Balun_SN002_NoDiodes_Measurements.ods

Sheet: Active_Balun_SN002_S11
! FILETYPE CSV
! VERSION 2.0 | 1
! TIMESTAMP Thursday | 09 July 2020 10:11:22
! TIMEZONE
! NAME Keysight Technologies
! MODEL N9926A
! SERIAL MY57271140
! FIRMWARE_VERSION A.10.18
! VF | 1
! Media | Coax
! IF_BW | 10000
! Output_Power_Mode | MAN
! Output_Power_Level | -45
! GPS_LATITUDE
! GPS_LONGITUDE
! GPS_TIMESTAMP 0001-01-01 00:00:00Z
! GPS_SECS_SINCE_LAST_READ 0
! CHECKSUM 2112721054
! CORRECTION1 ON U
! DATA Freq | S11
! FREQ UNIT Hz
! DATA UNIT dB
BEGIN
500000 | -2.8176923558
750000 | -3.4492855378
1000000 | -3.467794693
1250000 | -3.420057863
1500000 | -4.6709359665
1750000 | -4.4072235864
2000000 | -4.7538129865
2250000 | -4.3567444055
2500000 | -4.7050551186
2750000 | -5.1750230957
3000000 | -5.3856057834
3250000 | -4.9020137551
3500000 | -5.3402062561
3750000 | -6.1811415999
4000000 | -6.1405001767
4250000 | -5.7459996674
4500000 | -8.1309232226
4750000 | -8.4860032342
5000000 | -7.8279765744
5250000 | -6.5632969325
5500000 | -9.6433282351
5750000 | -8.9170672232
6000000 | -10.6403470979
6250000 | -10.1949468993
6500000 | -10.8995623183
6750000 | -9.3688324339
7000000 | -13.0627572139
7250000 | -12.413897343
7500000 | -9.7159736459
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
