zleffke/kicad_active_balun/rf_meas/bench/active_balun_sn002_39ohm/WithDiodes/Active_Balun_SN002_wDiodes_Measurements.ods

Sheet: Active_Balun_SN002_S11
! FILETYPE CSV
! VERSION 2.0 | 1
! TIMESTAMP Wednesday | 08 July 2020 23:32:01
! TIMEZONE
! NAME Keysight Technologies
! MODEL N9926A
! SERIAL MY57271140
! FIRMWARE_VERSION A.10.18
! VF | 1
! Media | Coax
! IF_BW | 10000
! Output_Power_Mode | MAN
! Output_Power_Level | -45
! GPS_LATITUDE
! GPS_LONGITUDE
! GPS_TIMESTAMP 0001-01-01 00:00:00Z
! GPS_SECS_SINCE_LAST_READ 0
! CHECKSUM 0199790231
! CORRECTION1 ON U
! DATA Freq | S11
! FREQ UNIT Hz
! DATA UNIT dB
BEGIN
500000 | -2.8092938405
750000 | -3.4139275126
1000000 | -3.3908054712
1250000 | -3.3962304485
1500000 | -4.5545687648
1750000 | -4.1120714872
2000000 | -4.3737527463
2250000 | -5.0803122602
2500000 | -4.7979263673
2750000 | -4.8924904133
3000000 | -5.1441546342
3250000 | -4.1888478775
3500000 | -5.9157718809
3750000 | -6.2609360449
4000000 | -5.7232259294
4250000 | -6.7477532391
4500000 | -9.1821526525
4750000 | -8.7150864539
5000000 | -8.9548918189
5250000 | -7.6588572067
5500000 | -9.779513521
5750000 | -8.9937075469
6000000 | -11.2887975904
6250000 | -10.2481034775
6500000 | -10.4080060769
6750000 | -9.4521761973
7000000 | -10.1464388189
7250000 | -10.3558284689
7500000 | -10.9461931105
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
