zleffke/kicad_active_balun/rf_meas/bench/active_balun_sn003_39ohm/noDiodes/Active_Balun_SN003_NoDiodes_Measurements.ods

Sheet: Active_Balun_SN003_S11
! FILETYPE CSV
! VERSION 2.0 | 1
! TIMESTAMP Monday | 06 July 2020 21:23:45
! TIMEZONE
! NAME Keysight Technologies
! MODEL N9926A
! SERIAL MY57271140
! FIRMWARE_VERSION A.10.18
! VF | 1
! Media | Coax
! IF_BW | 10000
! Output_Power_Mode | MAN
! Output_Power_Level | -45
! GPS_LATITUDE
! GPS_LONGITUDE
! GPS_TIMESTAMP 0001-01-01 00:00:00Z
! GPS_SECS_SINCE_LAST_READ 0
! CHECKSUM 2004829712
! CORRECTION1 ON U
! DATA Freq | S11
! FREQ UNIT Hz
! DATA UNIT dB
BEGIN
500000 | -2.8307756617
750000 | -3.5032224028
1000000 | -3.4046200994
1250000 | -3.3957140239
1500000 | -4.6046493934
1750000 | -4.1507775421
2000000 | -4.6475022931
2250000 | -4.7136996595
2500000 | -5.5372606955
2750000 | -4.8626550546
3000000 | -5.047168297
3250000 | -4.3978843477
3500000 | -6.1739797008
3750000 | -5.7173899546
4000000 | -5.4521235844
4250000 | -6.0891460397
4500000 | -8.744582436
4750000 | -8.9897832831
5000000 | -10.6627556573
5250000 | -8.0080690493
5500000 | -11.3913246908
5750000 | -10.726049708
6000000 | -10.1122089626
6250000 | -10.5235542267
6500000 | -12.0658885467
6750000 | -10.3580691373
7000000 | -11.6534971962
7250000 | -13.2440672275
7500000 | -12.841074043
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
