zleffke/kicad_active_balun/rf_meas/bench/active_balun_sn003_39ohm/withDiodes/Active_Balun_SN003_wDiodes_Measurements.ods

Sheet: Active_Balun_SN003_S11
! FILETYPE CSV
! VERSION 2.0 | 1
! TIMESTAMP Friday | 10 July 2020 11:50:49
! TIMEZONE
! NAME Keysight Technologies
! MODEL N9926A
! SERIAL MY57271140
! FIRMWARE_VERSION A.10.18
! VF | 1
! Media | Coax
! IF_BW | 10000
! Output_Power_Mode | MAN
! Output_Power_Level | -45
! GPS_LATITUDE
! GPS_LONGITUDE
! GPS_TIMESTAMP 0001-01-01 00:00:00Z
! GPS_SECS_SINCE_LAST_READ 0
! CHECKSUM 0263385973
! CORRECTION1 ON U
! DATA Freq | S11
! FREQ UNIT Hz
! DATA UNIT dB
BEGIN
500000 | -2.8107743995
750000 | -3.4693367095
1000000 | -3.3550610294
1250000 | -3.5294632838
1500000 | -4.6855877013
1750000 | -4.3204627497
2000000 | -4.9779597417
2250000 | -4.7670843703
2500000 | -5.5794294516
2750000 | -5.5759453869
3000000 | -5.7289531308
3250000 | -4.7119873454
3500000 | -7.2958823579
3750000 | -5.7448652102
4000000 | -7.3456037749
4250000 | -7.0163771819
4500000 | -8.1141655853
4750000 | -9.9168870155
5000000 | -8.8910729074
5250000 | -7.7927612485
5500000 | -9.5634737094
5750000 | -9.8466026505
6000000 | -11.3897724133
6250000 | -12.6959442639
6500000 | -10.0630644223
6750000 | -10.1223096506
7000000 | -13.2571312192
7250000 | -12.9329688418
7500000 | -10.8544621637
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
