zleffke/kicad_active_balun/rf_meas/bench/Calibration/noise_enviro_cal/N1E.ods

Sheet: N1E
Machine Module | N9343C | CN0605A298
MCU Version | A.06.27
DSP Version | A.05.02.02 SA
FPGA Version | A.02.80
03:27:58 07.09.2020
Y Axis Scale | LOG
Y Axis Unit | dBm
Impedance | 50
Number of Points | 461
Sweep Time(s) | 0.971373 | AUTO
Start Frequency | 0
Stop Frequency | 100000000
Frequency Offset | 0
Average Type | Log Pwr
RBW | 1000 | MAN
VBW | 1000 | AUTO
Sweep Type | Continuous
Sweep Mode | Sweep
Speed | Fast
PreAmp State | OFF
Ref Level | -40
Attenuation | 0 | MAN
Ref Level Offset | 0
X Axis Units | Hz
HiSensitive | OFF
Trigger Source | FreeRun
Trigger Level | 0
Trigger Slope | RISE
Trigger Delay | 0 | OFF
Gate Sweep | OFF
Gate View | OFF
Gate Delay | 0.00228
Gate Length | 0.00084
Gate Source | External
Burst Level | -20
Burst Trigger Slope | Rise
Timer Period | 0.00312
Timer Offset | 0
Sync Source | Off
Apply Corrections | OFF
Antenna Unit | OFF
Correction1 | Off
Correction2 | Off
Correction3 | Off
Correction4 | Off
Marker Information
CISPR Filter | Normal RBW | Dwell Time(s) | 0.5 | AUTO
Trace Math | Off
Trace Math By | Log Power
Trace Variable A | Trace1
Trace Variable B | Trace2
Trace Variable C | Trace3
Trace Name | Trace1
Trace Count | 1
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
