zleffke/kicad_active_balun/rf_meas/bench/Calibration/noise_enviro_cal/Noise_SN001_noEth_ACon.ods

Sheet: Noise_SN001_noEth_ACon
Frequency [Hz] | Frequency [MHz] | Power [dBm]
0 | 0 | -26.28720284
217391.3043 | 0.2173913043 | -83.02611542
434782.6087 | 0.4347826087 | -83.48800659
652173.913 | 0.652173913 | -92.34902954
869565.2174 | 0.8695652174 | -96.04518127
1086956.522 | 1.086956522 | -96.72671509
1304347.826 | 1.304347826 | -94.86367798
1521739.13 | 1.52173913 | -72.9797821
1739130.435 | 1.739130435 | -95.8925705
1956521.739 | 1.956521739 | -95.97962189
2173913.043 | 2.173913043 | -96.22860718
2391304.348 | 2.391304348 | -96.73358154
2608695.652 | 2.608695652 | -96.27385712
2826086.957 | 2.826086957 | -94.19096375
3043478.261 | 3.043478261 | -97.16604614
3260869.565 | 3.260869565 | -96.23234558
3478260.87 | 3.47826087 | -94.4526825
3695652.174 | 3.695652174 | -95.22167969
3913043.478 | 3.913043478 | -95.16396332
4130434.783 | 4.130434783 | -95.96027374
4347826.087 | 4.347826087 | -94.84165192
4565217.391 | 4.565217391 | -96.19139862
4782608.696 | 4.782608696 | -94.24949646
5000000 | 5 | -95.86398315
5217391.304 | 5.217391304 | -81.83332062
5434782.609 | 5.434782609 | -94.60541534
5652173.913 | 5.652173913 | -96.35468292
5869565.217 | 5.869565217 | -97.79294586
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
