zleffke/kicad_active_balun/rf_meas/bench/Calibration/ZFSC-2-4-S+/ZFSC-2-4-S+.ods

Sheet: ZFSC-2-4-S+
Frequency [kHz] | Frequency [MHz] | 1 to S S21 [dB] | 1 to S S12 [dB] | 1 to S IL [dB] | 2 to S S21 [dB] | 2 to S S12 [dB] | 2 to S AVG [dB] | IL AVG [dB]
500000 | 0.50 | -3.0040895591 | -3.3174158232 | 3.1607526911 | -3.117176374 | -3.4218786503 | 3.2695275121 | 3.2151401016
750000 | 0.75 | -3.5857700046 | -3.0659996271 | 3.3258848158 | -3.555870564 | -3.0488502937 | 3.3023604288 | 3.3141226223
1000000 | 1.00 | -3.7981310285 | -3.2994726501 | 3.5488018393 | -3.7647066602 | -3.281172778 | 3.5229397191 | 3.5358707792
1250000 | 1.25 | -3.2639721908 | -3.3590680261 | 3.3115201085 | -3.2024524939 | -3.4208158569 | 3.3116341754 | 3.3115771419
1500000 | 1.50 | -3.2904977088 | -3.4541807312 | 3.37233922 | -3.2650771478 | -3.4076019834 | 3.3363395656 | 3.3543393928
1750000 | 1.75 | -3.3655242999 | -3.2734954189 | 3.3195098594 | -3.4612592478 | -3.3101956638 | 3.3857274558 | 3.3526186576
2000000 | 2.00 | -3.225351082 | -3.161448986 | 3.193400034 | -3.3343534907 | -3.0823211627 | 3.2083373267 | 3.2008686804
2250000 | 2.25 | -3.2459613083 | -3.0090290424 | 3.1274951754 | -3.3464627576 | -3.1258948537 | 3.2361788056 | 3.1818369905
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
