zleffke/kicad_active_balun/rf_meas/bench/Calibration/ZMSCJ-2-1/ZMSCJ-2-1_Insertion_Loss.ods

Frequency [Hz] | S12 [dB]
500000 | -3.6980804513
750000 | -3.3382664936
1000000 | -3.6450214608
1250000 | -3.6770081932
1500000 | -3.8458936241
1750000 | -3.5171580474
2000000 | -3.4332374031
2250000 | -3.1576850165
2500000 | -3.7959280816
2750000 | -3.8407060595
3000000 | -3.9242221167
3250000 | -3.5962300636
3500000 | -3.798482323
3750000 | -3.5840419622
4000000 | -3.9914025971
4250000 | -3.0709248322
4500000 | -3.8642724489
4750000 | -3.4223322303
5000000 | -3.3352469001
5250000 | -3.2167061514
5500000 | -3.5650534744
5750000 | -3.6803880507
6000000 | -4.0596360967
6250000 | -3.48326905
6500000 | -3.885523985
6750000 | -3.7160097455
7000000 | -3.4088012911
7250000 | -3.7002472713
7500000 | -3.4577047362
7750000 | -3.3715721149
8000000 | -3.4960549421
8250000 | -3.5091205114
8500000 | -3.5065713764
8750000 | -3.6736528557
9000000 | -3.5508775557
9250000 | -3.7555503558
9500000 | -3.6245131689
9750000 | -3.7028942635
10000000 | -3.5247182
10250000 | -3.6504475154
10500000 | -3.389006711
10750000 | -3.6026805238
11000000 | -3.5783719667
11250000 | -3.3359517685
11500000 | -3.4471325386
11750000 | -3.5298032728
12000000 | -3.7096854192
12250000 | -3.8205935105
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
