zleffke/kicad_active_balun/rf_meas/bench/PGA103_VJB/8v_33ohm/PGA-103_VJB_8v33ohm_Measurements.ods

Sheet: PGA-103+_VJB_33Ohm_S11
! FILETYPE CSV
! VERSION 2.0 | 1
! TIMESTAMP Saturday | 25 July 2020 10:57:19
! TIMEZONE
! NAME Keysight Technologies
! MODEL N9926A
! SERIAL MY57271140
! FIRMWARE_VERSION A.10.18
! VF | 1
! Media | Coax
! IF_BW | 10000
! Output_Power_Mode | MAN
! Output_Power_Level | -45
! GPS_LATITUDE
! GPS_LONGITUDE
! GPS_TIMESTAMP 0001-01-01 00:00:00Z
! GPS_SECS_SINCE_LAST_READ 0
! CHECKSUM 0847544282
! CORRECTION1 ON U
! DATA Freq | S11
! FREQ UNIT Hz
! DATA UNIT dB
BEGIN
500000 | -0.4318406588
750000 | -0.3826632618
1000000 | -0.3404062144
1250000 | -0.2260514208
1500000 | -0.4651900407
1750000 | -0.0666257877
2000000 | -0.2448753729
2250000 | -0.6388923143
2500000 | -0.3980369734
2750000 | 0.0473779743
3000000 | -0.1587437213
3250000 | 0.0909606774
3500000 | -0.0472584987
3750000 | -0.4085736408
4000000 | -0.2986357405
4250000 | -0.4535140267
4500000 | -0.4798697009
4750000 | -0.3257851991
5000000 | -0.2161394715
5250000 | -0.0420562116
5500000 | -0.539973549
5750000 | -0.6683664962
6000000 | -0.6487487253
6250000 | -0.828643191
6500000 | -0.7326858893
6750000 | -0.532405433
7000000 | -0.4068525148
7250000 | -0.5300374822
7500000 | -0.2805678531
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
