zleffke/kicad_active_balun/rf_meas/bench/Calibration/ZFSC-2-4-S+/ZFSC-2-4-S+_1to2_S11.csv

! FILETYPE CSV
! VERSION 2.0 | 1
! TIMESTAMP Saturday | 04 July 2020 11:54:47
! TIMEZONE
! NAME Keysight Technologies
! MODEL N9926A
! SERIAL MY57271140
! FIRMWARE_VERSION A.10.18
! VF | 1.000
! Media | Coax
! IF_BW | 10000
! Output_Power_Mode | MAN
! Output_Power_Level | -45
! GPS_LATITUDE
! GPS_LONGITUDE
! GPS_TIMESTAMP 0001-01-01 00:00:00Z
! GPS_SECS_SINCE_LAST_READ 0
! CHECKSUM 0124904963
! CORRECTION1 ON U
! DATA Freq | S11
! FREQ UNIT Hz
! DATA UNIT dB
BEGIN
500000 | -21.3217251719149
750000 | -22.2073134735401
1000000 | -24.5033162651238
1250000 | -23.9259255828044
1500000 | -22.748386950689
1750000 | -27.5039084239551
2000000 | -22.9784071154517
2250000 | -25.5569732031906
2500000 | -23.8016125668408
2750000 | -26.9844135211862
3000000 | -22.6582281238352
3250000 | -34.2955663010342
3500000 | -22.4501273025401
3750000 | -32.3409995095714
4000000 | -28.5255958789436
4250000 | -27.6397373337371
4500000 | -26.1642781777498
4750000 | -25.1429167711904
5000000 | -24.6743795435993
5250000 | -27.229546916058
5500000 | -30.4993740918663
5750000 | -21.4455456803589
6000000 | -23.7096484413695
6250000 | -27.4594559624007
6500000 | -22.1198673463616
6750000 | -23.0791501539689
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
