zleffke/kicad_active_balun/rf_meas/bench/Calibration/ZFSC-2-4-S+/ZFSC-2-4-S+_1to2_S12.csv

! FILETYPE CSV
! VERSION 2.0 | 1
! TIMESTAMP Saturday | 04 July 2020 11:55:48
! TIMEZONE
! NAME Keysight Technologies
! MODEL N9926A
! SERIAL MY57271140
! FIRMWARE_VERSION A.10.18
! VF | 1.000
! Media | Coax
! IF_BW | 10000
! Output_Power_Mode | MAN
! Output_Power_Level | -45
! GPS_LATITUDE
! GPS_LONGITUDE
! GPS_TIMESTAMP 0001-01-01 00:00:00Z
! GPS_SECS_SINCE_LAST_READ 0
! CHECKSUM 1675473251
! CORRECTION1 ON U
! DATA Freq | S12
! FREQ UNIT Hz
! DATA UNIT dB
BEGIN
500000 | -33.5561257643412
750000 | -32.4575809207231
1000000 | -34.4019126834127
1250000 | -37.8264505923424
1500000 | -33.5180764893544
1750000 | -34.2400619009014
2000000 | -34.9882729945983
2250000 | -34.4232987740665
2500000 | -35.840483258596
2750000 | -38.0636898060833
3000000 | -35.3785919294673
3250000 | -36.2775174403623
3500000 | -34.9841879499447
3750000 | -35.0345944522272
4000000 | -34.4474355561346
4250000 | -35.1656226723403
4500000 | -34.6669715073859
4750000 | -35.361292292604
5000000 | -33.8420617324144
5250000 | -38.0166576370328
5500000 | -37.3568964015207
5750000 | -38.2398051282402
6000000 | -36.2759510278833
6250000 | -38.018097251094
6500000 | -39.9085881123586
6750000 | -36.2205613728449
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
