zleffke/kicad_active_balun/rf_meas/bench/Calibration/ZFSC-2-4-S+/ZFSC-2-4-S+_1to2_S21.csv

! FILETYPE CSV
! VERSION 2.0 | 1
! TIMESTAMP Saturday | 04 July 2020 11:55:22
! TIMEZONE
! NAME Keysight Technologies
! MODEL N9926A
! SERIAL MY57271140
! FIRMWARE_VERSION A.10.18
! VF | 1.000
! Media | Coax
! IF_BW | 10000
! Output_Power_Mode | MAN
! Output_Power_Level | -45
! GPS_LATITUDE
! GPS_LONGITUDE
! GPS_TIMESTAMP 0001-01-01 00:00:00Z
! GPS_SECS_SINCE_LAST_READ 0
! CHECKSUM 1579093047
! CORRECTION1 ON U
! DATA Freq | S21
! FREQ UNIT Hz
! DATA UNIT dB
BEGIN
500000 | -35.6922042427718
750000 | -34.9067603803359
1000000 | -35.5272576279618
1250000 | -34.5605823105444
1500000 | -35.0312416691245
1750000 | -38.9079784047085
2000000 | -34.8344853158038
2250000 | -34.1058000821909
2500000 | -34.2027340779113
2750000 | -32.8431728123617
3000000 | -35.4805918942391
3250000 | -38.8716723262353
3500000 | -34.9495548866172
3750000 | -35.5408457730251
4000000 | -35.0044023525995
4250000 | -37.9364163334114
4500000 | -33.8198039203322
4750000 | -37.0083471878705
5000000 | -35.3598929181113
5250000 | -37.7735497478719
5500000 | -35.6899112953775
5750000 | -34.9997210281782
6000000 | -33.8600946653545
6250000 | -38.9360675333064
6500000 | -38.5831622239323
6750000 | -36.1511661204584
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
