zleffke/kicad_active_balun/rf_meas/bench/Calibration/ZFSC-2-4-S+/ZFSC-2-4-S+_1to2_S22.csv

! FILETYPE CSV
! VERSION 2.0 | 1
! TIMESTAMP Saturday | 04 July 2020 11:56:26
! TIMEZONE
! NAME Keysight Technologies
! MODEL N9926A
! SERIAL MY57271140
! FIRMWARE_VERSION A.10.18
! VF | 1.000
! Media | Coax
! IF_BW | 10000
! Output_Power_Mode | MAN
! Output_Power_Level | -45
! GPS_LATITUDE
! GPS_LONGITUDE
! GPS_TIMESTAMP 0001-01-01 00:00:00Z
! GPS_SECS_SINCE_LAST_READ 0
! CHECKSUM 0686880639
! CORRECTION1 ON U
! DATA Freq | S22
! FREQ UNIT Hz
! DATA UNIT dB
BEGIN
500000 | -20.5455817140098
750000 | -22.957395775219
1000000 | -28.7238609580774
1250000 | -30.9695897670386
1500000 | -27.2688923293002
1750000 | -22.8266014552581
2000000 | -26.2430382164015
2250000 | -36.4942403755356
2500000 | -23.7819398103468
2750000 | -27.0909821648265
3000000 | -26.3431037407501
3250000 | -31.3854501093012
3500000 | -25.8390091824909
3750000 | -27.2604096215387
4000000 | -35.8537978230883
4250000 | -30.8561351467155
4500000 | -25.8604357770618
4750000 | -29.961663758006
5000000 | -22.1215851605645
5250000 | -30.087884701183
5500000 | -27.1833776873057
5750000 | -23.7177125604896
6000000 | -27.563111100139
6250000 | -27.2824856732041
6500000 | -24.6196365578302
6750000 | -30.3204642542625
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
