zleffke/kicad_active_balun/rf_meas/bench/Calibration/ZFSC-2-4-S+/ZFSC-2-4-S+_1toS_S11.csv

! FILETYPE CSV
! VERSION 2.0 | 1
! TIMESTAMP Saturday | 04 July 2020 11:59:06
! TIMEZONE
! NAME Keysight Technologies
! MODEL N9926A
! SERIAL MY57271140
! FIRMWARE_VERSION A.10.18
! VF | 1.000
! Media | Coax
! IF_BW | 10000
! Output_Power_Mode | MAN
! Output_Power_Level | -45
! GPS_LATITUDE
! GPS_LONGITUDE
! GPS_TIMESTAMP 0001-01-01 00:00:00Z
! GPS_SECS_SINCE_LAST_READ 0
! CHECKSUM 0322966696
! CORRECTION1 ON U
! DATA Freq | S11
! FREQ UNIT Hz
! DATA UNIT dB
BEGIN
500000 | -24.4441877055423
750000 | -21.5180503404623
1000000 | -24.263973261922
1250000 | -24.0044802578551
1500000 | -22.8024670551736
1750000 | -24.36022365925
2000000 | -25.5488152618029
2250000 | -25.5574453429045
2500000 | -28.8722798320529
2750000 | -25.7688548058851
3000000 | -23.6008043328697
3250000 | -29.1224151445836
3500000 | -23.1748534825121
3750000 | -27.145073872317
4000000 | -25.1688176469717
4250000 | -31.3183255827181
4500000 | -31.2480424874853
4750000 | -30.0575973634381
5000000 | -24.6281059247594
5250000 | -29.870311219458
5500000 | -26.2647984194051
5750000 | -24.0005941528694
6000000 | -26.7191512696859
6250000 | -29.7692600478654
6500000 | -24.1031107404784
6750000 | -22.3900120632199
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
