zleffke/kicad_active_balun/rf_meas/bench/Calibration/ZFSC-2-4-S+/ZFSC-2-4-S+_1toS_S12.csv

! FILETYPE CSV
! VERSION 2.0 | 1
! TIMESTAMP Saturday | 04 July 2020 12:01:40
! TIMEZONE
! NAME Keysight Technologies
! MODEL N9926A
! SERIAL MY57271140
! FIRMWARE_VERSION A.10.18
! VF | 1.000
! Media | Coax
! IF_BW | 10000
! Output_Power_Mode | MAN
! Output_Power_Level | -45
! GPS_LATITUDE
! GPS_LONGITUDE
! GPS_TIMESTAMP 0001-01-01 00:00:00Z
! GPS_SECS_SINCE_LAST_READ 0
! CHECKSUM 0705529801
! CORRECTION1 ON U
! DATA Freq | S12
! FREQ UNIT Hz
! DATA UNIT dB
BEGIN
500000 | -3.31741582320365
750000 | -3.06599962705845
1000000 | -3.29947265007444
1250000 | -3.35906802614245
1500000 | -3.45418073124402
1750000 | -3.27349541894479
2000000 | -3.16144898602576
2250000 | -3.00902904242479
2500000 | -3.55574403506518
2750000 | -3.56631794302489
3000000 | -3.60512042435027
3250000 | -3.40189861189383
3500000 | -3.4773047545955
3750000 | -3.47499805794496
4000000 | -3.79478897918508
4250000 | -2.8057054180144
4500000 | -3.58583469443621
4750000 | -3.26839307082058
5000000 | -3.01367111346276
5250000 | -3.18271974151077
5500000 | -3.41324550521746
5750000 | -3.56490875693431
6000000 | -3.74707686107548
6250000 | -3.28783719574845
6500000 | -3.52166133101885
6750000 | -3.42989148410462
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
