zleffke/kicad_active_balun/docs/hamsci_20200723/images/Test_Equipment.jpg

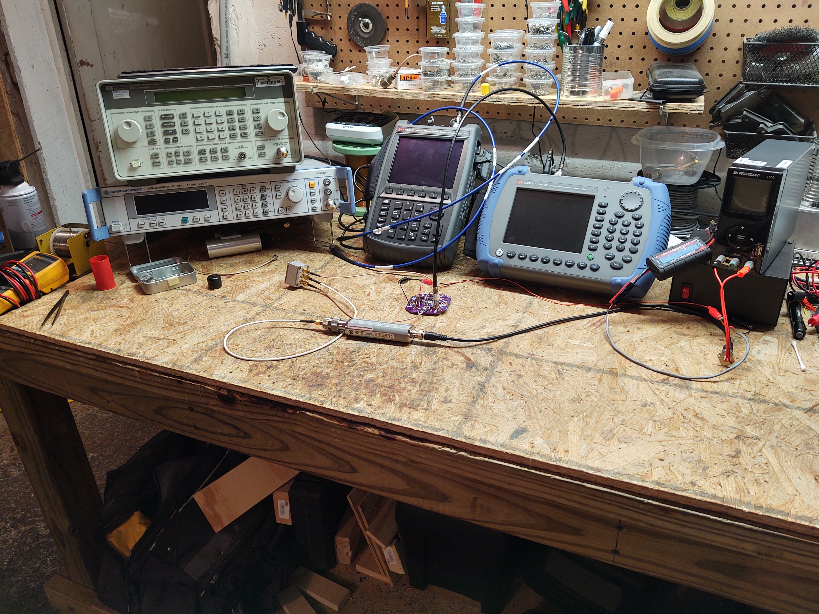
docs/hamsci_20200723/images/Test_Equipment.jpg
