zleffke/kicad_active_balun/rf_meas/bench/Calibration/noise_enviro_cal/Noise_SN001_noEth_ACoff.JPG

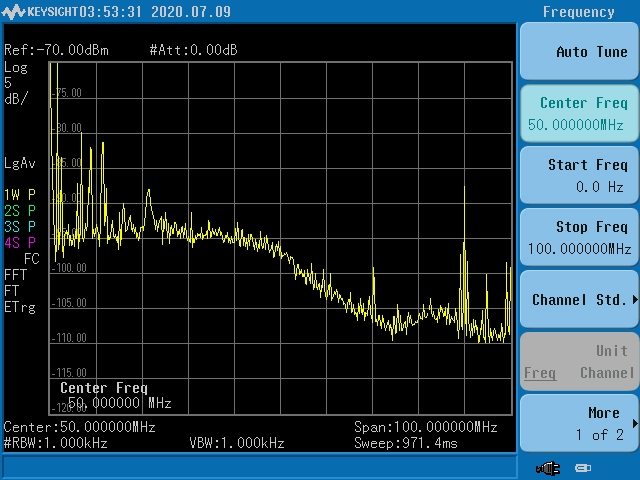
rf_meas/bench/Calibration/noise_enviro_cal/Noise_SN001_noEth_ACoff.JPG
