zleffke/kicad_active_balun/docs/Initial Design/sections/revisions.tex

\newpage
\appendix
\section*{APPENDIX - Revision History}
\label{sec:revisions}
\addcontentsline{toc}{section}{\protect\numberline{}APPENDIX - Revision History}%

\renewcommand{\arraystretch}{1.2}
%\begin{center}
\begin{table}[H]
	\captionof{table}{Revision History} 
	\label{tab:title}
	\begin{tabular}{|c|c|l|}
		%%--BEGIN TABLE HEADER--
		\hline
		\textbf{Version} & 
		\textbf{Date} & 
		\textbf{Description} \hfill\\
		\hline
		%%--END HEADER---
		%Insert New Revisions ABOVE old revisions, 
		%  keeping most current information at top of list.
		
		0.0.1 & 2020-06-29 & Initial Document Generation\\
		\hline
	\end{tabular}
\end{table}
%\end{center}
