zleffke/kicad_active_balun/rf_meas/bench/active_balun_sn002_39ohm/troubleshooting/Active_Balun_SN002_S11_Prob1.png

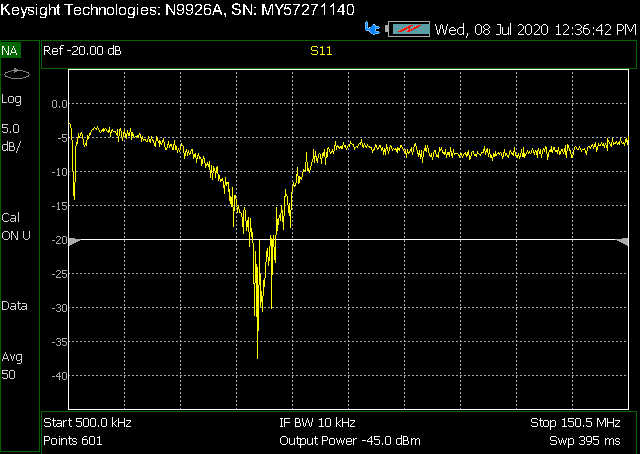
rf_meas/bench/active_balun_sn002_39ohm/troubleshooting/Active_Balun_SN002_S11_Prob1.png
