zleffke/kicad_active_balun/docs/diagrams/Test Setup Block Diagrams.pdf

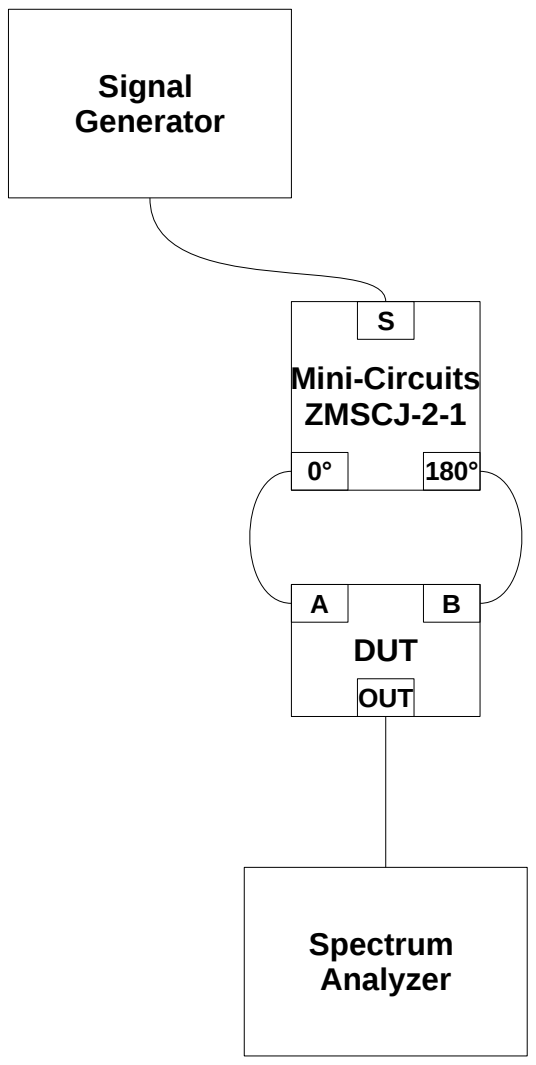
[picture p114: page 1]
Signal Generator; Mini-Circuits ZMSCJ-2-1; OUT; DUT; Spectrum Analyzer

Page Name: Linearity Measurement | Project Name: Active Crossed Dipole HF Antenna | Author: Zach Leffke, KJ4QLP | Page: 1 / 3

Document Name: Test Measurement Setup Diagrams | | | Date: 20200623

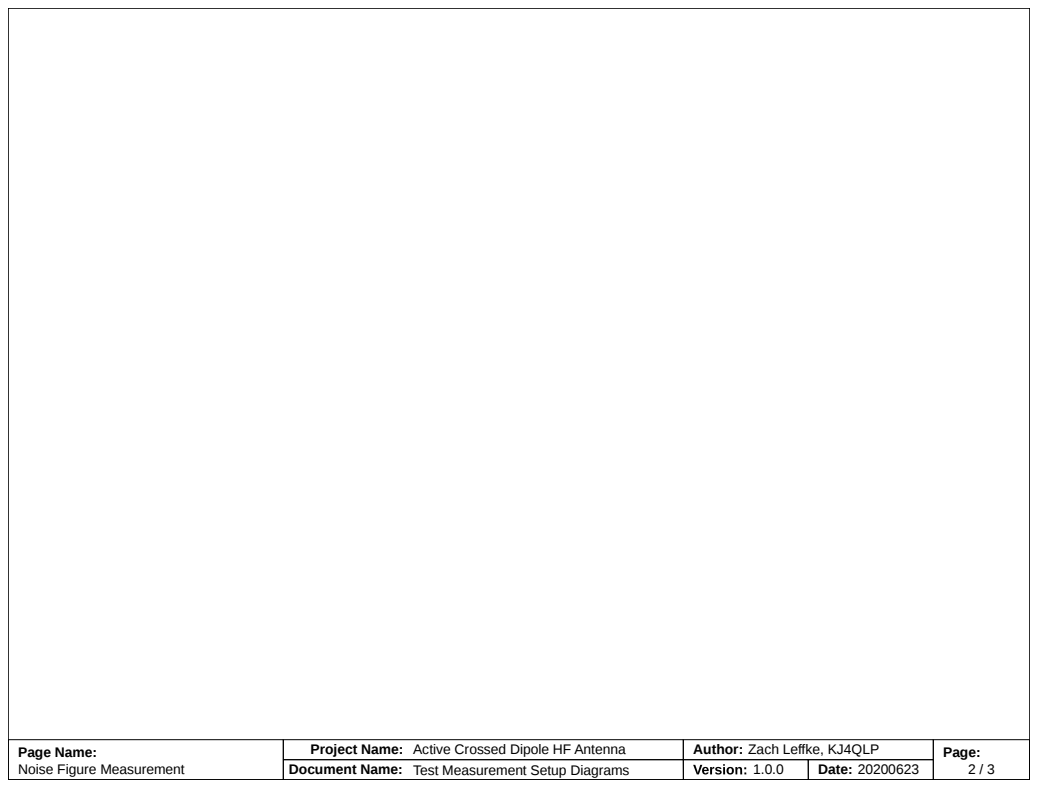
[picture p115: page 2]

Page Name: Noise Figure Measurement | Project Name: Active Crossed Dipole HF Antenna | Author: Zach Leffke, KJ4QLP | Page: 2 / 3

Document Name: | | | Date: 20200623

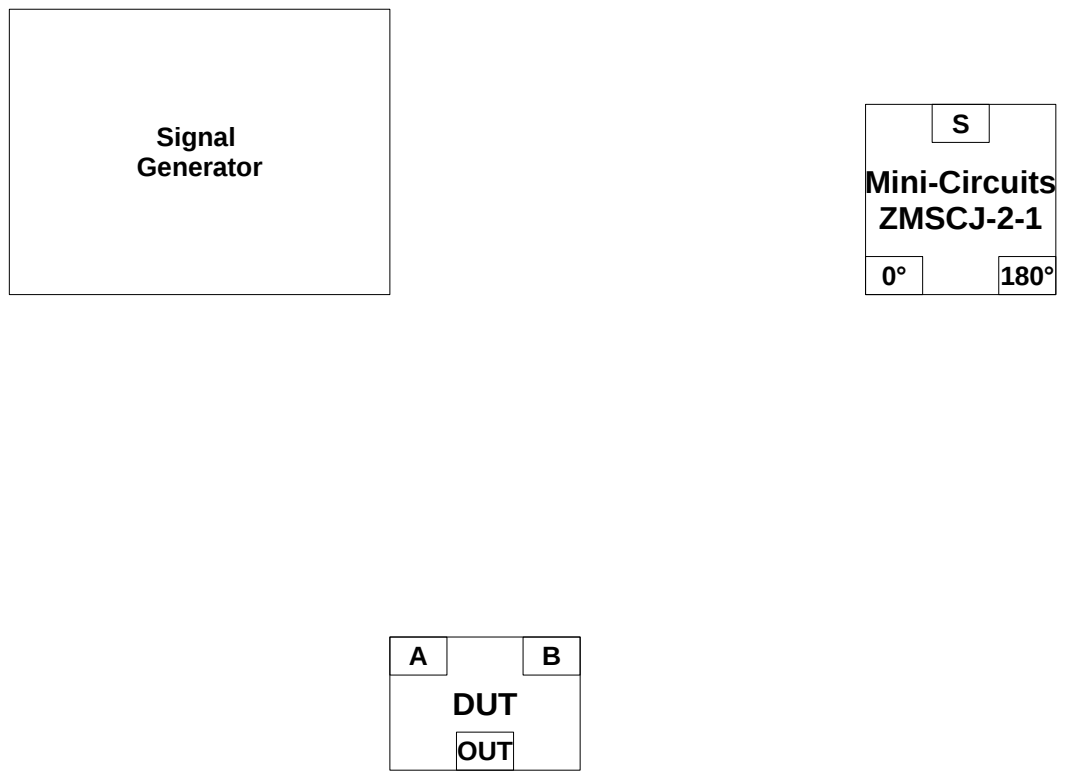
[picture p116: page 3]
Signal Generator; Mini-Circuits ZMSCJ-2-1; OUT; DUT

Page Name: Parts Page – Delete When Done | Project Name: Active Crossed Dipole HF Antenna | Author: Zach Leffke, KJ4QLP | Page: 3 / 3

Document Name: | | | Date: 20200623
