zleffke/kicad_active_balun/active_balun_v1/rev-/active_balun_v1_rev-.pdf

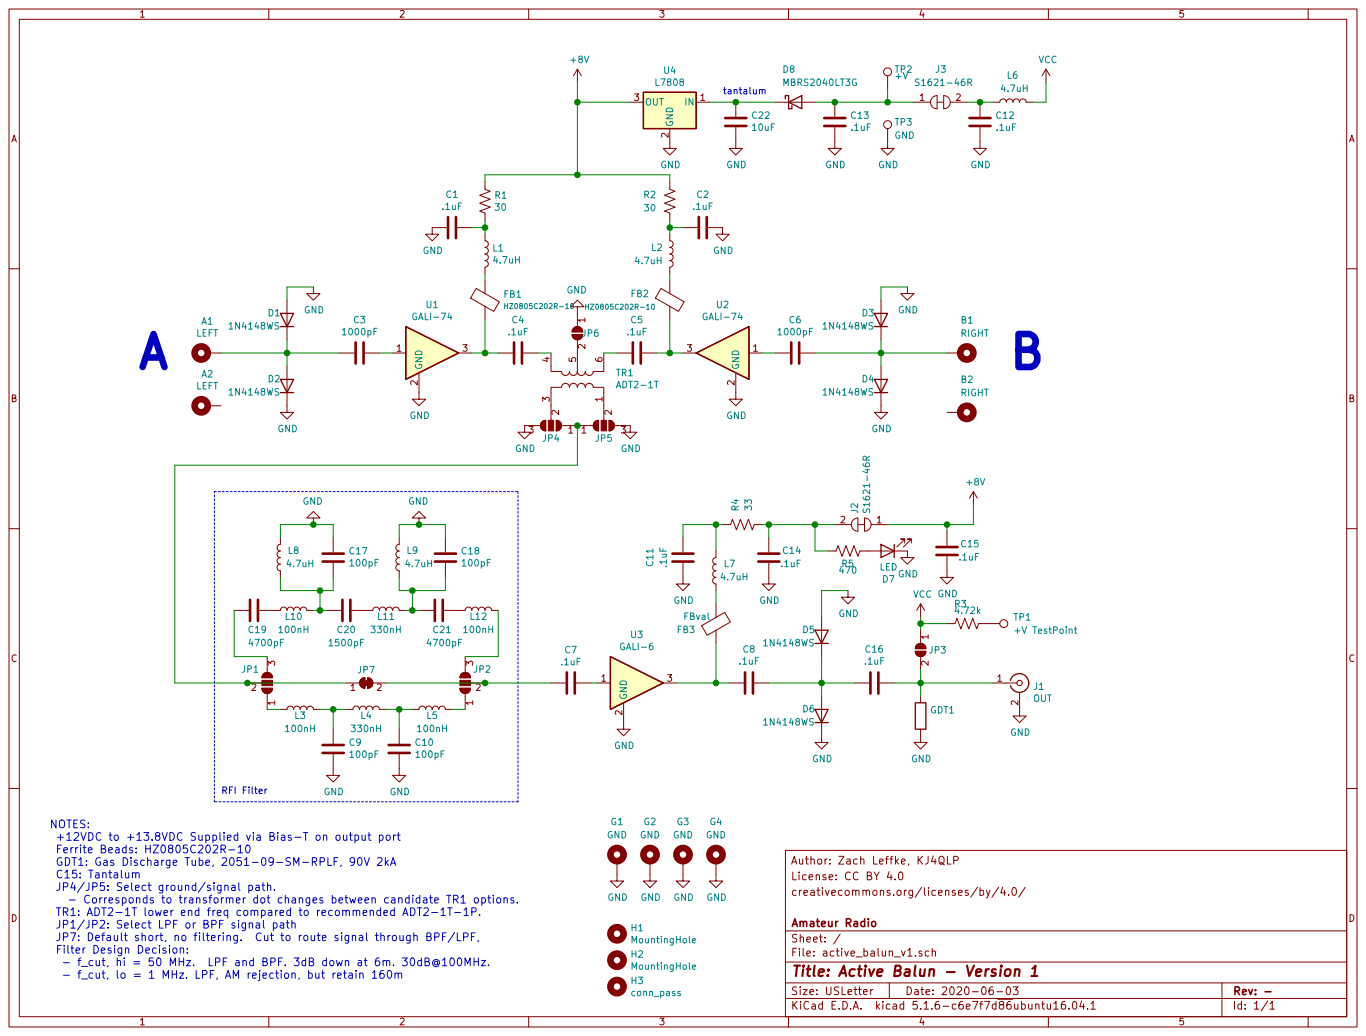
[picture p117: page 1]

+12VDC to +13.8VDC Supplied via Bias-T on output port
Ferrite Beads: HZ0805C202R-10
GDT1: Gas Discharge Tube, 2051-09-SM-RPLF, 90V 2kA
C15: Tantalum
JP4/JP5: Select ground/signal path.
- Corresponds to transformer dot changes between candidate TR1 options.
TR1: ADT2-1T lower end freq compared to recommended ADT2-1T-1P.
JP1/JP2: Select LPF or BPF signal path
JP7: Default short, no filtering. Cut to route signal through BPF/LPF,
Filter Design Decision:
- f_cut, hi = 50 MHz. LPF and BPF. 3dB down at 6m. 30dB@100MHz.
- f_cut, lo = 1 MHz. LPF, AM rejection, but retain 160m

creativecommons.org/licenses/by/4.0/ License: CC BY 4.0 Author: Zach Leffke, KJ4QLP

File: active_balun_v1.sch Sheet: / Amateur Radio

Id: 1/1 Title: Active Balun - Version 1
