zleffke/kicad_active_balun/active_balun_v1/rev-/active_balun_v1.kicad_pcb

## KiCad design active_balun_v1/rev-/active_balun_v1.kicad_pcb (2020-06-15)

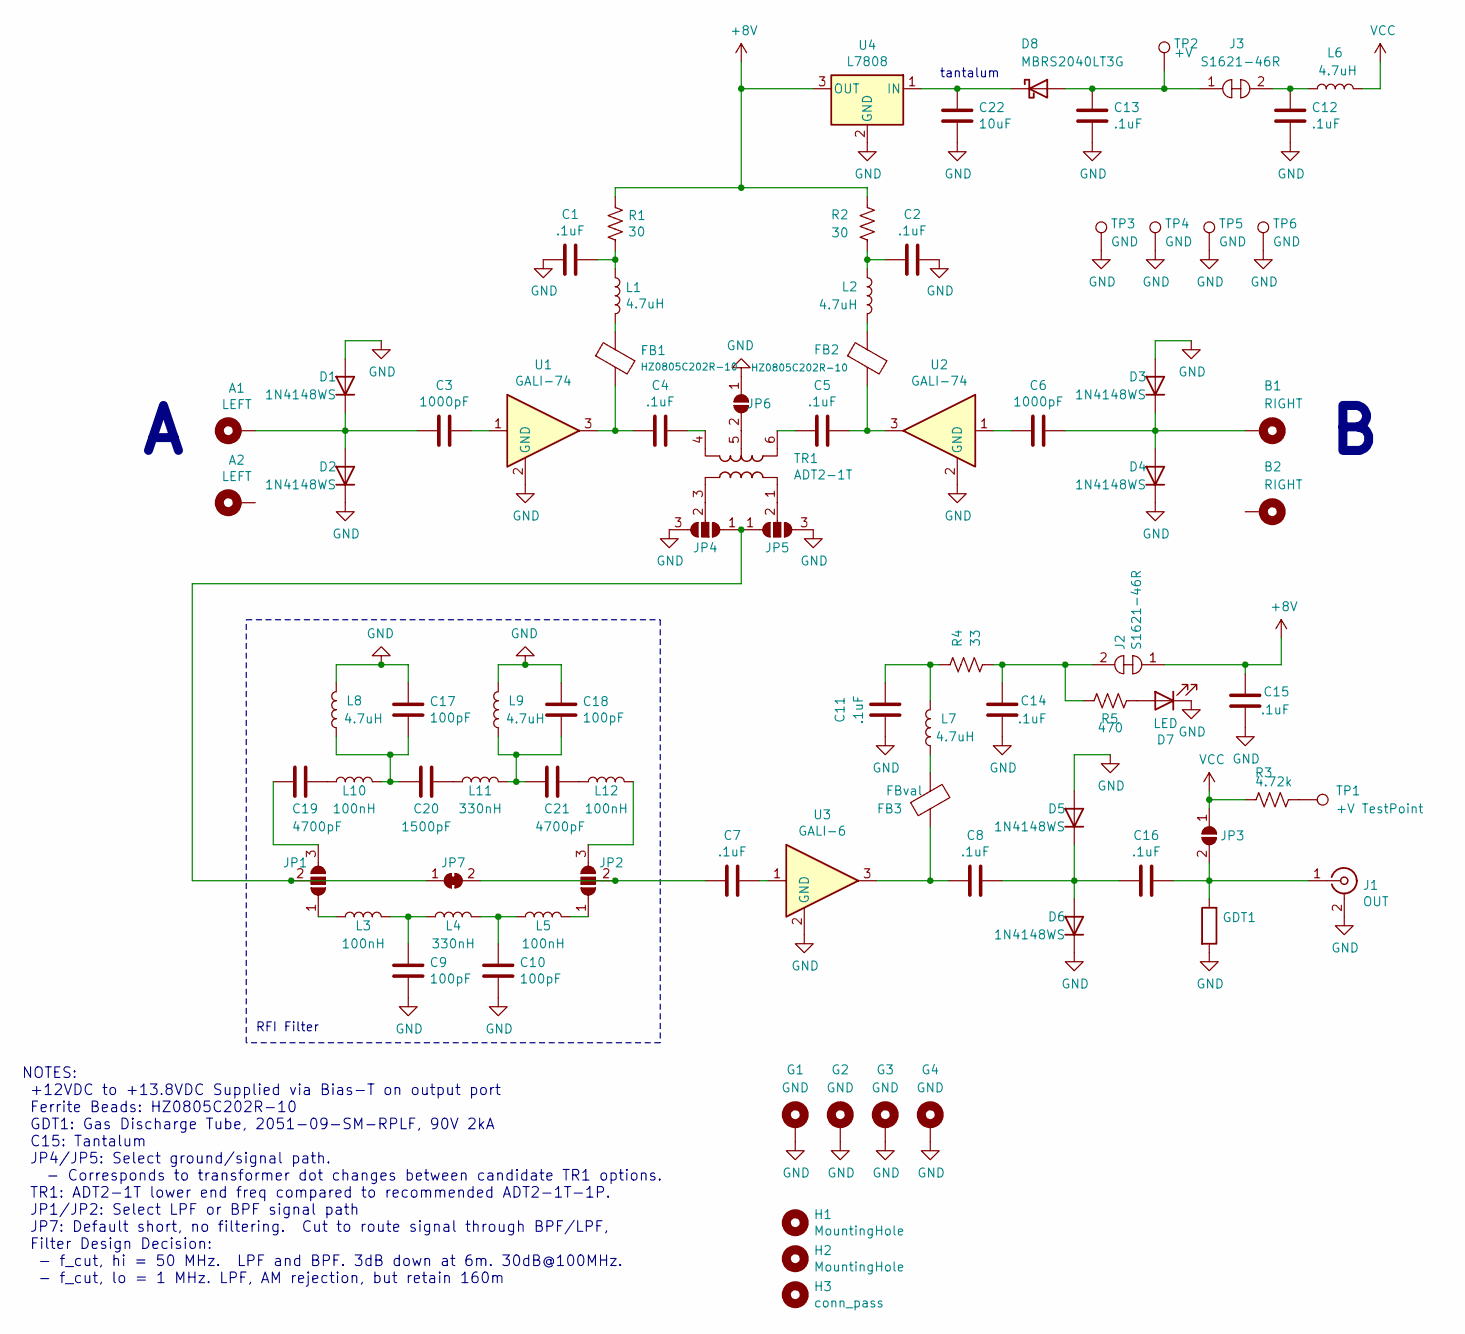
[picture p118: schematic active_balun_v1.sch, Active Balun - Version 1]

Parts:
A1, A2: LEFT; MountingHole_3.7mm_Pad_Via
B1, B2: RIGHT; MountingHole_3.7mm_Pad_Via
C1, C2, C4, C5, C7, C8, C11, C12, C13, C14, C15, C16: .1uF; 0805
C3, C6: 1000pF; 0805
C9, C10, C17, C18: 100pF; 0805
C19, C21: 4700pF; 0805
C20: 1500pF; 0805
C22: 10uF; CP_EIA-3528-15_AVX-H
D1, D2, D3, D4, D5, D6: 1N4148WS; D_SOD-323
D7: LED; LED_0805_2012Metric
D8: MBRS2040LT3G; D_SMB_Handsoldering
FB1, FB2: HZ0805C202R-10; 0805
FB3: FBval; 0805
G1, G2, G3, G4: GND; MountingHole_3.2mm_M3_Pad_Via
GDT1: L_1812_4532Metric
H1, H2: MountingHole; MountingHole_3.2mm_M3
H3: conn_pass; MountingHole_3.2mm_M3
J1: OUT; SMA_Amphenol_132134_Vertical
J2, J3: S1621-46R; Jumper_Tin_P10.9mm; MPN S1621-46R; Digi-Key_PN 952-1474-1-ND
JP1, JP2, JP4, JP5: SolderJumper-3_P1.3mm_Open_RoundedPad1.0x1.5mm
JP3, JP6: SolderJumper-2_P1.3mm_Open_RoundedPad1.0x1.5mm
JP7: NetTie-2_SMD_Pad0.5mm
L1, L2, L7, L8, L9: 4.7uH; 0805
L3, L5, L10, L12: 100nH; 0805
L4, L11: 330nH; 0805
L6: 4.7uH; L_1008_2520Metric
R1, R2: 30; R_1206_3216Metric
R3: 4.72k; 0805
R4: 33; R_1206_3216Metric
R5: 470; 0805
TP1: +V TestPoint; TestPoint_Pad_D2.0mm
TP2: +V; TestPoint_Pad_2.5x2.5mm
TP3, TP4, TP5, TP6: GND; TestPoint_Pad_2.5x2.5mm
TR1: ADT2-1T; Mini-Circuits_CD542_H2.84mm
U1, U2: GALI-74; SOT-89-3
U3: GALI-6; SOT-89-3
U4: L7808; TO-263-2

Connections:
+8V: C15.2, J2.1, R1.1, R2.1, U4.3 (OUT)
GND: C1.2, C2.1, C9.1, C10.1, C11.2, C12.1, C13.1, C14.1, C15.1, C17.2, C18.2, C22.1, D1.2 (A), D2.1 (K), D3.2 (A), D4.1 (K), D5.2 (A), D6.1 (K), D7.1 (K), G1.1, G2.1, G3.1, G4.1, GDT1.2, J1.2 (Ext), JP4.3 (B), JP5.3 (B), JP6.1 (A), L8.2, L9.2, TP3.1, TP4.1, TP5.1, TP6.1, U1.2 (GND), U2.2 (GND), U3.2 (GND), U4.2 (GND)
unnamed: A1.1, C3.2, D1.1 (K), D2.2 (A)
unnamed: B1.1, C6.1, D3.1 (K), D4.2 (A)
unnamed: C1.1, L1.1, R1.2
unnamed: C2.2, L2.1, R2.2
unnamed: C3.1, U1.1
unnamed: C4.1, TR1.4
unnamed: C4.2, FB1.2, U1.3
unnamed: C5.1, FB2.2, U2.3
unnamed: C5.2, TR1.6
unnamed: C6.2, U2.1
unnamed: C7.1, U3.1
unnamed: C7.2, JP2.2 (C), JP7.2 (B)
unnamed: C8.1, FB3.1, U3.3
unnamed: C9.2, L3.2, L4.1
unnamed: C10.2, L4.2, L5.1
unnamed: C11.1, L7.2, R4.2
unnamed: C12.2, J3.2, L6.2
unnamed: C13.2, D8.2 (A), J3.1, TP2.1
unnamed: C14.2, J2.2, R4.1, R5.1
unnamed: C8.2, C16.1, D5.1 (K), D6.2 (A)
unnamed: C16.2, GDT1.1, J1.1 (In), JP3.2 (B)
unnamed: C17.1, C20.1, L8.1, L10.2
unnamed: C18.1, C21.1, L9.1, L11.2
unnamed: C19.1, JP1.3 (B)
unnamed: C19.2, L10.1
unnamed: C20.2, L11.1
unnamed: C21.2, L12.1
unnamed: C22.2, D8.1 (K), U4.1 (IN)
unnamed: D7.2 (A), R5.2
unnamed: FB1.1, L1.2
unnamed: FB2.1, L2.2
unnamed: FB3.2, L7.1
unnamed: JP1.1 (A), L3.1
unnamed: JP1.2 (C), JP4.1 (A), JP5.1 (A), JP7.1 (A)
unnamed: JP2.1 (A), L5.2
unnamed: JP2.3 (B), L12.2
unnamed: JP4.2 (C), TR1.3
unnamed: JP5.2 (C), TR1.1
unnamed: JP6.2 (B), TR1.5
unnamed: R3.1, TP1.1
VCC: JP3.1 (A), L6.1, R3.2

Notes on the sheet:
NOTES: +12VDC to +13.8VDC Supplied via Bias-T on output port Ferrite Beads: HZ0805C202R-10 GDT1: Gas Discharge Tube, 2051-09-SM-RPLF, 90V 2kA C15: Tantalum JP4/JP5: Select ground/signal path. - Corresponds to transformer dot changes between candidate TR1 options. TR1: ADT2-1T lower end freq compare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
tantalum
RFI Filter

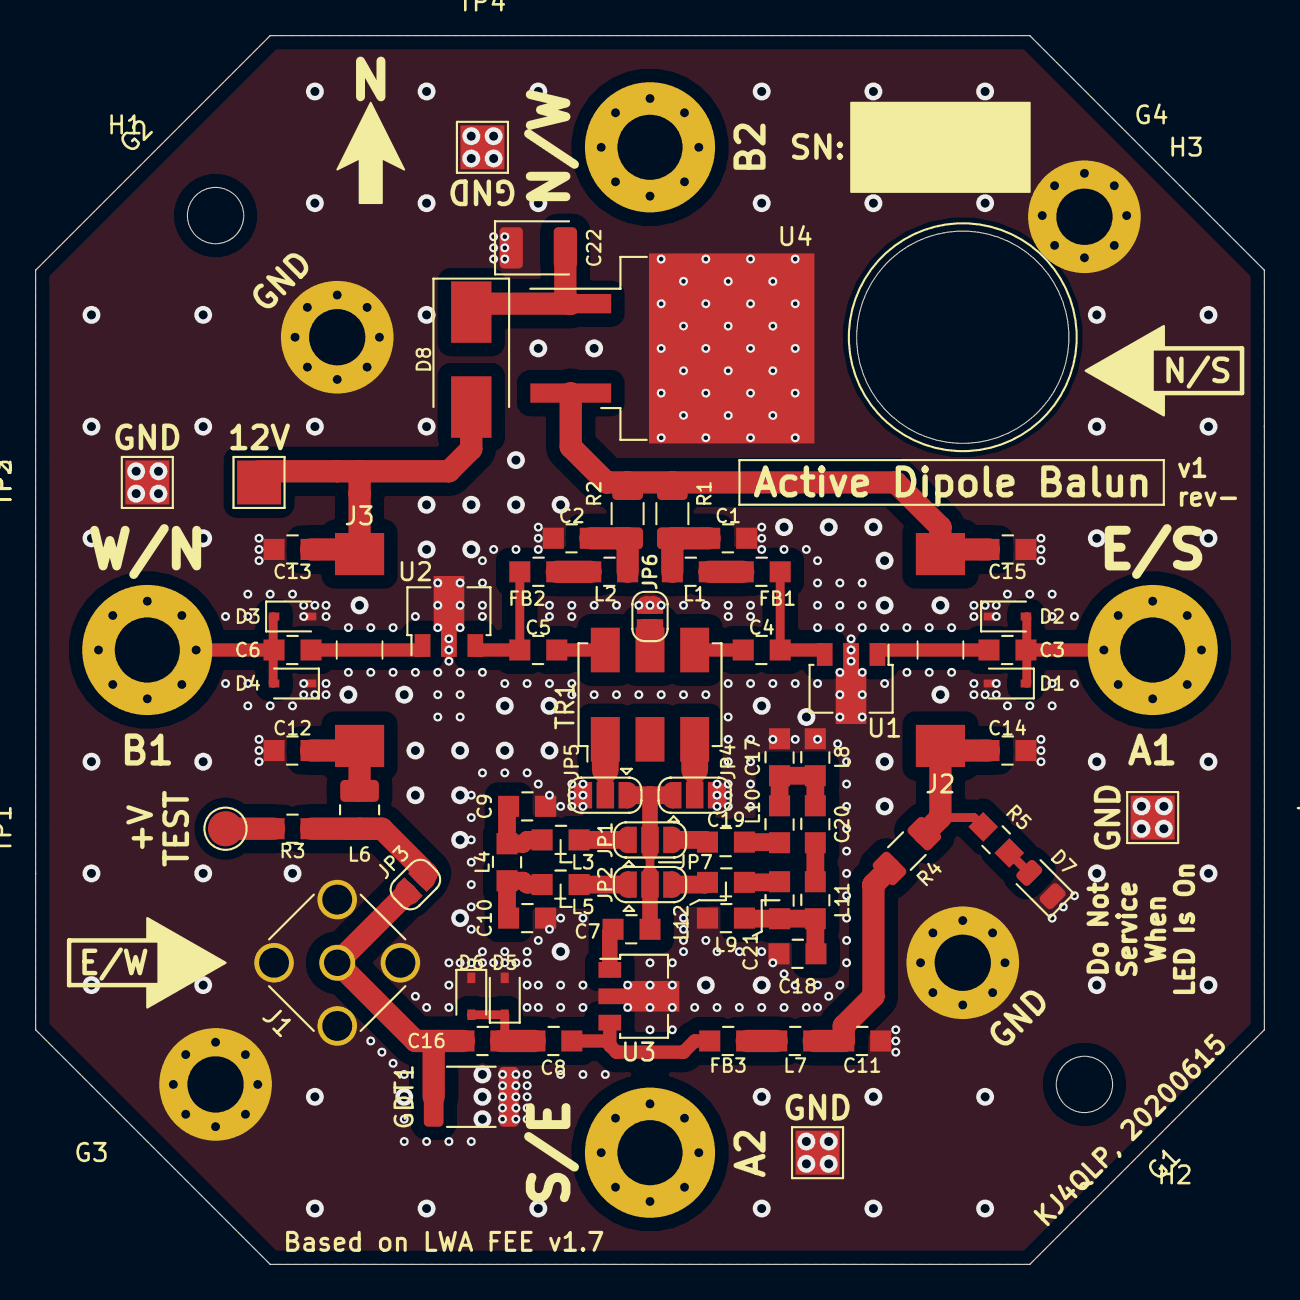
[picture p119: board active_balun_v1.kicad_pcb from above]

Board: 2 copper layers, 69.8 x 69.8 mm, 83 parts (0 on the bottom side), 43 nets.
