zleffke/kicad_active_balun/(commit log)

2020-06-15 mass commit of completed v1, rev1. This commit submitted to Osh Park, 20200615.
    [active_balun_v1.kicad_pcb, active_balun_v1.sch, active_balun_v1_rev-_bom.ods]
2020-06-15 qucs designs. lpf and bpf designs for active dipole balun.
    [bpf_2MHz_60MHz.sch, lwa_bpf.sch, lwa_bpf2.sch, lwa_bpf3.sch, lwa_bpf_1MHz_50MHz.sch, lwa_lpf.sch, lwa_lpf_50MHz.sch, lwa_lpf_60MHz.sch]
2020-08-22 added documentation and rf measurement data.....its a big repo now...
    [ACTIVE_BALUN_PGA103_30ohm.ods, ACTIVE_BALUN_SN001_39ohm.ods, ACTIVE_BALUN_SN001_NoDiodes_39ohm.ods, ACTIVE_BALUN_SN002_39ohm.ods, ACTIVE_BALUN_SN003.ods, ACTIVE_BALUN_SN003_39ohm.ods, ACTIVE_BALUN_SN003_NoDiodes_30ohm.ods, ACTIVE_BALUN_SN003_NoDiodes_39ohm.ods]
