zleffke/kicad_active_balun/docs/hamsci_20200723/images/wire_element.jpg

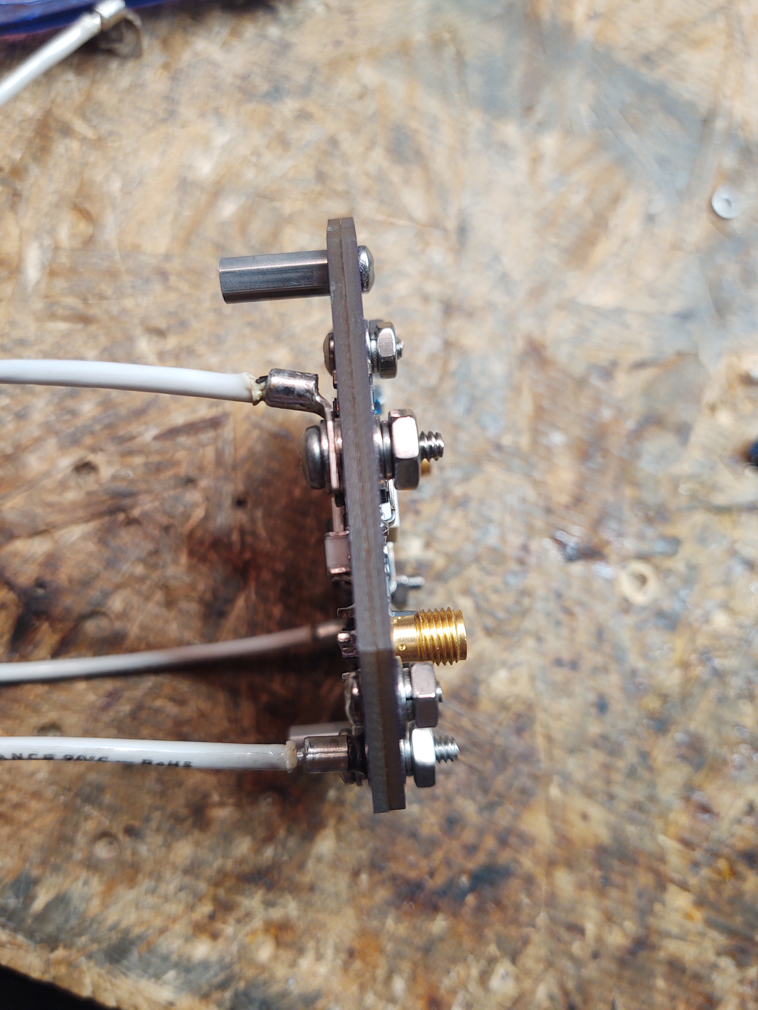
docs/hamsci_20200723/images/wire_element.jpg
