zleffke/kicad_active_balun/docs/hamsci_20200723/images/assemble_noRadome.jpg

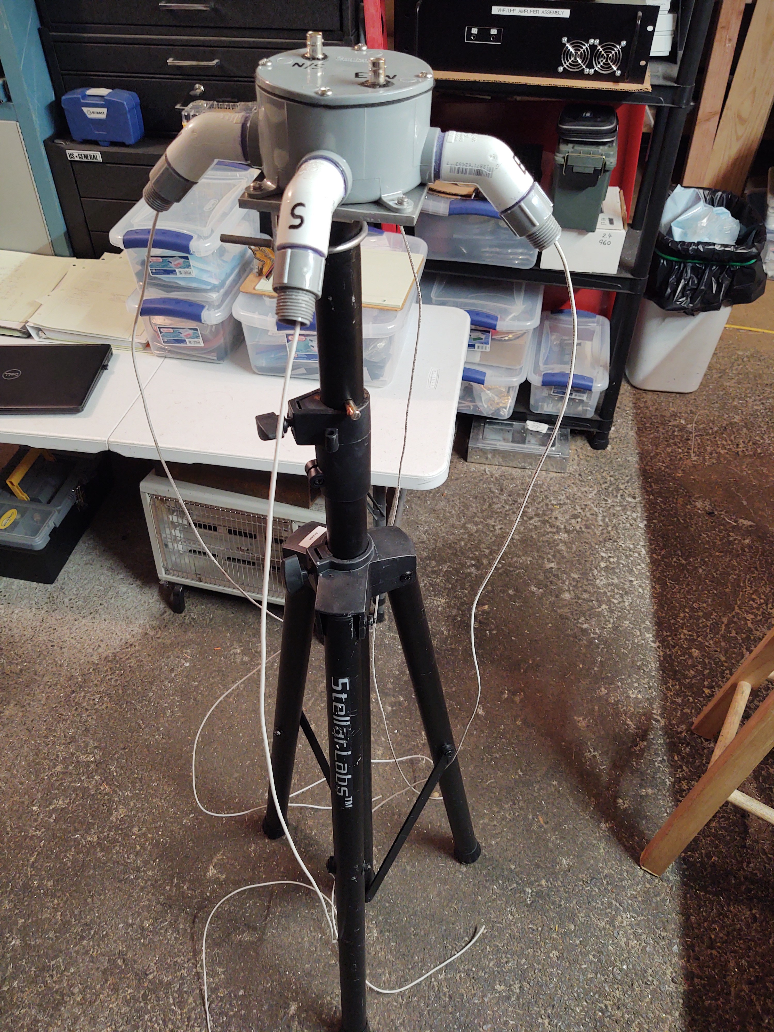
docs/hamsci_20200723/images/assemble_noRadome.jpg
