zleffke/kicad_active_balun/docs/hamsci_20200723/images/assemble_tripod.jpg

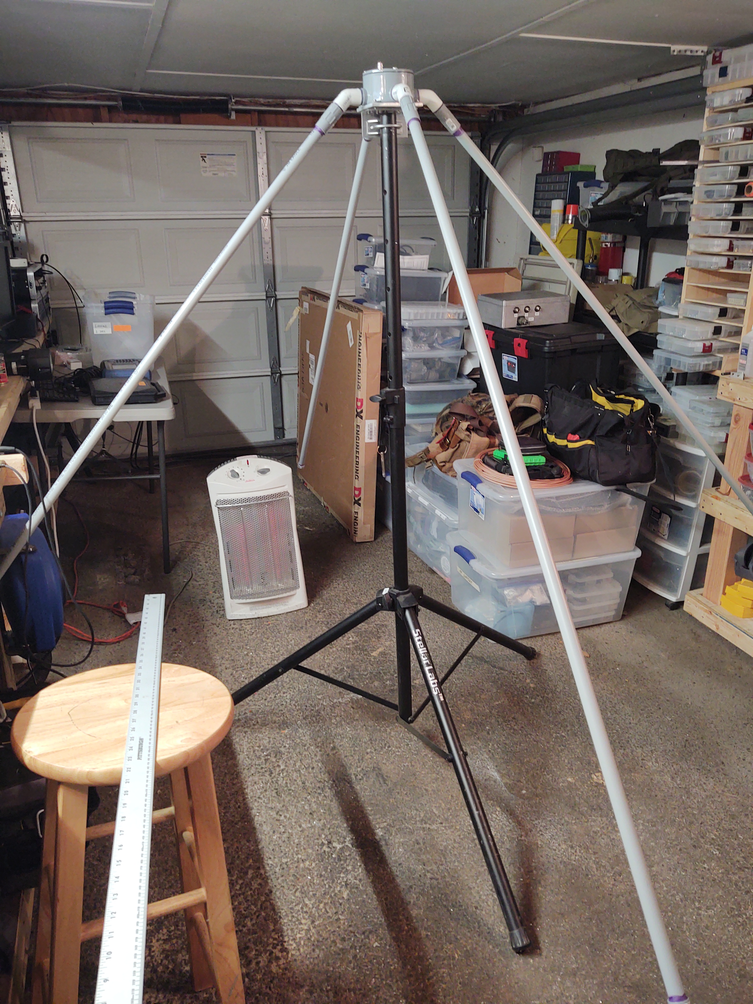
docs/hamsci_20200723/images/assemble_tripod.jpg
